EchoMAV/echopilot_ai_carrier/echopilot_ai_carrier_bom.xlsx

EchoPilot AI Carrier - Public Release
Item | Qty | Reference(s) | Value | LibPart | Footprint | Part Num | Notes
1 | 1 | BT1 | MS421R | Device:Battery_Cell | UVDL:SEIKO_ML414H_IV01E | MS421R IV03E
2 | 6 | C1, C2, C3, C4, C20, C21 | 0.1uF | Device:C | Capacitors_SMD:C_0201 | GRM033R61E104KE14J
3 | 2 | C5, C6 | 1000pF | Device:C | Capacitors_SMD:C_0201 | GRM033R71H102KA12D
4 | 6 | C7, C8, C10, C11, C12, C13 | 2.2uF 100V | Device:C | Capacitors_SMD:C_1206 | 12061C225KAT2A
5 | 1 | C9 | 10uF 100V | Device:C | Capacitors_SMD:C_1210 | GRM32EC72A106KE05L
6 | 2 | C14, C15 | 10nF | Device:C | Capacitors_SMD:C_0201 | GRM033R71E103KE14D
7 | 2 | C16, C17 | 4.7nF | Device:C | Capacitors_SMD:C_0201 | GRM033R61E472KA12D
8 | 2 | C18, C19 | 47pF | Device:C | Capacitors_SMD:C_0402 | C0402C470J3RACAUTO
9 | 6 | C22, C23, C24, C25, C26, C27 | 47uF 10V | Device:C | Capacitors_SMD:C_1206 | CL31A476MPHNNNE
10 | 7 | C28, C29, C33, C34, C38, C39, C41 | 0.1uF | Device:C | Capacitor_SMD:C_0201_0603Metric | GRM033R61E104KE14J
11 | 4 | C30, C31, C35, C36 | 47pF | Device:C | Capacitor_SMD:C_0201_0603Metric | 02013A470JAT2A
12 | 3 | C32, C37, C40 | 4.7uF | Device:C | Capacitor_SMD:C_0805_2012Metric | CL21B475KOFNFNE
13 | 3 | C42, C43, C44 | 1.0uF | Device:C | Capacitor_SMD:C_0805_2012Metric | C2012X7R1E105K125AB
14 | 1 | C45 | 0.1uF | Device:C | Capacitor_SMD:C_0402_1005Metric | CL05B104KB5NNNC
15 | 1 | C46 | 1.0uF | Device:C | Capacitor_SMD:C_0201_0603Metric | CL03A105MO3NRNH
16 | 1 | C47 | 5600pF | Device:C | Capacitor_SMD:C_0201_0603Metric | GRM033R61E562KA12D
17 | 1 | C48 | 0.47uF | Device:C | Capacitor_SMD:C_0201_0603Metric | EMK063BBJ474KPLF
18 | 1 | D1 | TVS | osrf_device_fork:TVS | Diodes_SMD:D_SOD-123F | ATV02W101B-HF
19 | 2 | D2, D3 | PDS760-13 | Device:D_Schottky | UVDL:PDS760-13 | PDS760-13
20 | 2 | D4, D5 | LED_G | Device:LED | LEDs:LED_0603 | 150060VS75000
21 | 1 | D6 | D_Zener | Device:D_Zener | Diodes_SMD:D_SOD-523 | MM5Z12VT1G
22 | 1 | D7 | ZLLS410TA | Device:D_Schottky | Diode_SMD:D_SOD-323 | ZLLS410TA
23 | 2 | D8, D9 | D_Schottky | Device:D_Schottky | Diode_SMD:D_SMA | B340LA-13-F
24 | 1 | D10 | D_Schottky | Device:D_Schottky | Diode_SMD:D_0402_1005Metric | CDBQC0130L-HF
25 | 1 | D11 | Part Num | Diode:1.5KExxA | Diode_SMD:D_0402_1005Metric | PESD0402-140
26 | 1 | F1 | 0603L100SLYR | Device:Polyfuse | Fuse:Fuse_0603_1608Metric | 0603L100SLYR
27 | 2 | FB1, FB2 | MPZ1608Y101BTA00 | Device:FerriteBead | Inductor_SMD:L_0603_1608Metric | MPZ1608Y101BTA00
28 | 2 | FL1, FL2 | ECMF02-2AMX6 | archangel:ECMF02 | UVDL:QFN-6L_STM | ECMF02-2AMX6
29 | 2 | J5, J6 | FX23L-80P-0.5SV8 | fx23l-80p-0.5sv8:FX23L-80P-0.5SV8 | UVDL:Hirose-FX23L-80P-0.5SV8-MFG | FX23L-80P-0.5SV8 | optional, increase to 10mm gap between boards to provide additional clearance, use FX23L-80P-0.5SV10
30 | 2 | J7, J29 | USB_C_Receptacle_USB2.0 | Connector:USB_C_Receptacle_USB2.0 | Connector_USB:USB_C_Receptacle_Amphenol_12401610E4-2A | 12401610E4#2A
31 | 1 | J8 | 1-84952-5 | :Conn_01x15_1 | UVDL:TE_1-84952-5 | 1-84952-5
32 | 9 | J9, J15, J17, J19, J21, J22, J23, J24, J25 | Conn_01x04 | Connector_Generic:Conn_01x04 | Connector_JST:JST_GH_SM04B-GHS-TB_1x04-1MP_P1.25mm_Horizontal | SM04B-GHS-TB(LF)(SN)
33 | 1 | J10 | 532617010 | Connector_Generic:Conn_01x10 | Connectors_Molex:Molex_PicoBlade_53261-1071_10x1.25mm_Angled | 532617010
34 | 1 | J11 | Conn_01x02 | Connector_Generic:Conn_01x02 | Connectors_JST:JST_GH_SM02B-GHS-TB_02x1.25mm_Angled | SM02B-GHS-TB(LF)(SN)
35 | 1 | J12 | Conn_01x04 | Connector_Generic:Conn_01x04 | Connectors_JST:JST_GH_SM04B-GHS-TB_04x1.25mm_Angled | SM04B-GHS-TB(LF)(SN)
36 | 2 | J13, J26 | Conn_01x03 | Connector_Generic:Conn_01x03 | Connector_JST:JST_GH_SM03B-GHS-TB_1x03-1MP_P1.25mm_Horizontal | SM03B-GHS-TB(LF)(SN)
37 | 1 | J14 | 1-84952-5 | Connector_Generic:Conn_01x15 | UVDL:TE_1-84952-5 | 1-84952-5
38 | 1 | J16 | Conn_01x03 | Connector_Generic:Conn_01x03 | Connectors_JST:JST_GH_SM03B-GHS-TB_03x1.25mm_Angled | SM03B-GHS-TB(LF)(SN)
39 | 1 | J18 | Conn_01x06 | Connector_Generic:Conn_01x06 | Connector_JST:JST_GH_SM06B-GHS-TB_1x06-1MP_P1.25mm_Horizontal | SM06B-GHS-TB(LF)(SN)
40 | 1 | J20 | Conn_01x10 | Connector_Generic:Conn_01x10 | Connectors_JST:JST_GH_SM10B-GHS-TB_10x1.25mm_Angled | SM10B-GHS-TB(LF)(SN)
41 | 1 | J27 | XT30PW-M | Connector_Generic:Conn_01x02 | UVDL:AMASS_XT30PW-M_1x02_P2.50mm_Horizontal | XT30PW-M
42 | 1 | J28 | Conn_01x14 | Connector_Generic:Conn_01x14 | Connector_JST:JST_GH_SM14B-GHS-TB_1x14-1MP_P1.25mm_Horizontal | SM14B-GHS-TB(LF)(SN)-
43 | 2 | L1, L2 | ASPIAIG-F1040-7R3M-T | Device:L | UVDL:ASPIAIG-F1040-7R3M-T | ASPIAIG-F1040-7R3M-T
44 | 1 | L3 | 47uH | Device:L | UVDL:IND_LQH32CN470K23L | LQH32CN470K23L
45 | 1 | Q1 | Q_NMOS_GSD | Device:Q_NMOS_GSD | TO_SOT_Packages_SMD:SOT-23 | BSS214NH6327XTSA1
46 | 1 | Q2 | SQJ463EP-T1_GE3 | 2023-02-23_20-09-27:SQJ463EP-T1_GE3 | UVDL:TO_63EP-T1_GE3_VIS | SQJ463EP-T1_GE3
47 | 2 | R1, R28 | 10K | Device:R | Resistor_SMD:R_0201_0603Metric | ERJ-1GNF1002C
48 | 1 | R2 | 220 | Device:R | Resistor_SMD:R_0201_0603Metric | ERJ-1GNF2200C
49 | 2 | R3, R4 | 75 | Device:R | Resistor_SMD:R_0201_0603Metric | ERJ-1GNF75R0C
50 | 1 | R5 | 750m | Device:R | Resistors_SMD:R_0402 | ERJ-2BQJR75X
51 | 2 | R6, R7 | 16.9K | Device:R | Resistor_SMD:R_0201_0603Metric | ERJ-1GNF1692C
52 | 2 | R8, R9 | 243K | Device:R | Resistor_SMD:R_0201_0603Metric | ERJ-1GNF2433C
53 | 1 | R14 | 56.0K | Device:R | Resistor_SMD:R_0201_0603Metric | RC0201FR-0756KL
54 | 1 | R10 | 57.6K | Device:R | Resistor_SMD:R_0201_0603Metric | RC0201FR-0757K6L
55 | 4 | R11, R13, R22, R23 | 5.1K | Device:R | Resistor_SMD:R_0201_0603Metric | ERJ-1GNJ512C
56 | 2 | R12, R15 | 10.2K | Device:R | Resistor_SMD:R_0201_0603Metric | ERJ-1GNF1022C
57 | 2 | R16, R17 | 1.0K | Device:R | Resistor_SMD:R_0201_0603Metric | ERJ-1GEF1001C
58 | 1 | R18 | 10K | Device:R | Resistors_SMD:R_0402 | ERJ-PA2J103X
59 | 1 | R19 | 100 | Device:R | Resistor_SMD:R_0201_0603Metric | ERJ-U01F1000C
60 | 4 | R20, R21, R24, R25 | 27 | Device:R | Resistor_SMD:R_0201_0603Metric | ERJ-1GNJ270C
61 | 1 | R26 | 3.3K | Device:R | Resistor_SMD:R_0402_1005Metric | ERJ-PA2F3301X
62 | 1 | R27 | 9.09K | Device:R | Resistor_SMD:R_0201_0603Metric | ERJ-1GNF9091C
63 | 1 | R29 | 100K | Device:R | Resistor_SMD:R_0201_0603Metric | ERJ-1GEF1003C
64 | 1 | R30 | 453K | Device:R | Resistor_SMD:R_0201_0603Metric | ERJ-1GNF4533C
65 | 1 | R31 | 16.5K | Device:R | Resistor_SMD:R_0201_0603Metric | ERJ-1GNF1652C
66 | 1 | SW1 | SW_PUSH | osrf_device_fork:SW_PUSH | UVDL:SW_B3U-1000P | B3U-1000P
67 | 1 | TP1 | TestPoint | Connector:TestPoint | Measurement_Points:Test_Point_Keystone_5015_Micro-Minature | 5015 | Mfg: Keystone
68 | 2 | U1, U2 | HX0068ANLT | Microhard:HX0068ANLT | Nightcrawler:HX0068ANLT_r2 | HX0068ANLT
69 | 2 | U3, U4 | TPS54561QDPRRQ1 | TPS54561DPRR:TPS54561DPRR | UVDL:SON80P400X400X80-11N | TPS54561QDPRRQ1
70 | 2 | U5, U6 | FT231XQ-R | archangel:FT231XQ | UVDL:QFN20_FT231XQ_FTD | FT231XQ-R
71 | 1 | U7 | VN200 | VN200:VN200 | UVDL:7X8CASTLE | DNI | DNI - Optional installation of VectorNAV INS VN-X00
72 | 1 | U8 | AP2112K-3.3 | Regulator_Linear:AP2112K-3.3 | Package_TO_SOT_SMD:SOT-23-5 | AP2112K-3.3TRG1
73 | 1 | U9 | LT3469 | cube_base:LT3469 | Package_TO_SOT_SMD:SOT-23-8 | LT3469ETS8#TRMPBF
