EchoMAV/echopilot_ai_carrier/(threads)

Thread 1 (2024-05-02):

MIPI 3.3V

climr, 2024-05-02:
is limited to 2A by the protection circuit, but the upstream regulator is only rated for 1A.  So a short circuit could damage the regulator.
