EchoMAV/echopilot_ai_carrier/echopilot_ai_carrier_schematic.pdf

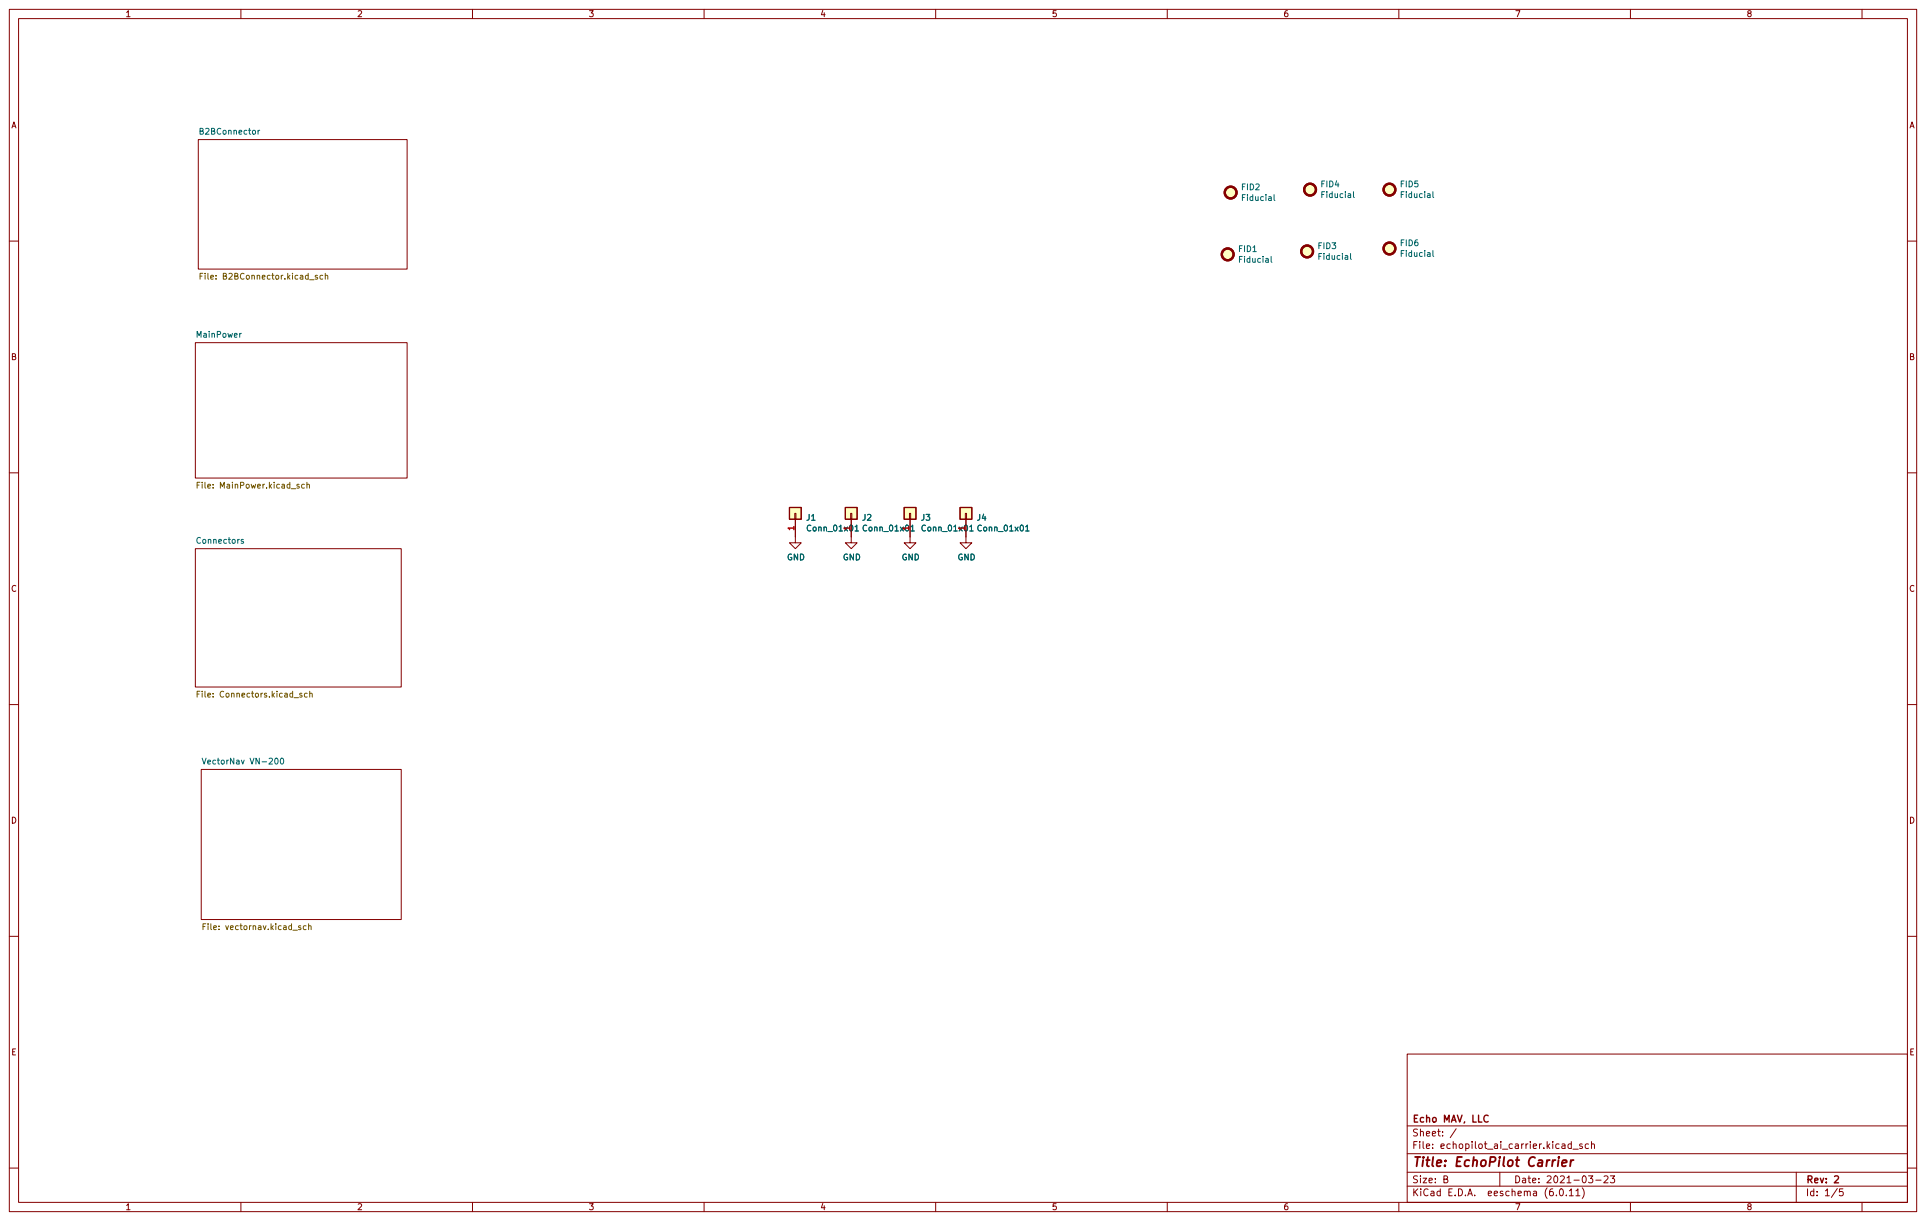
[picture p1: page 1]

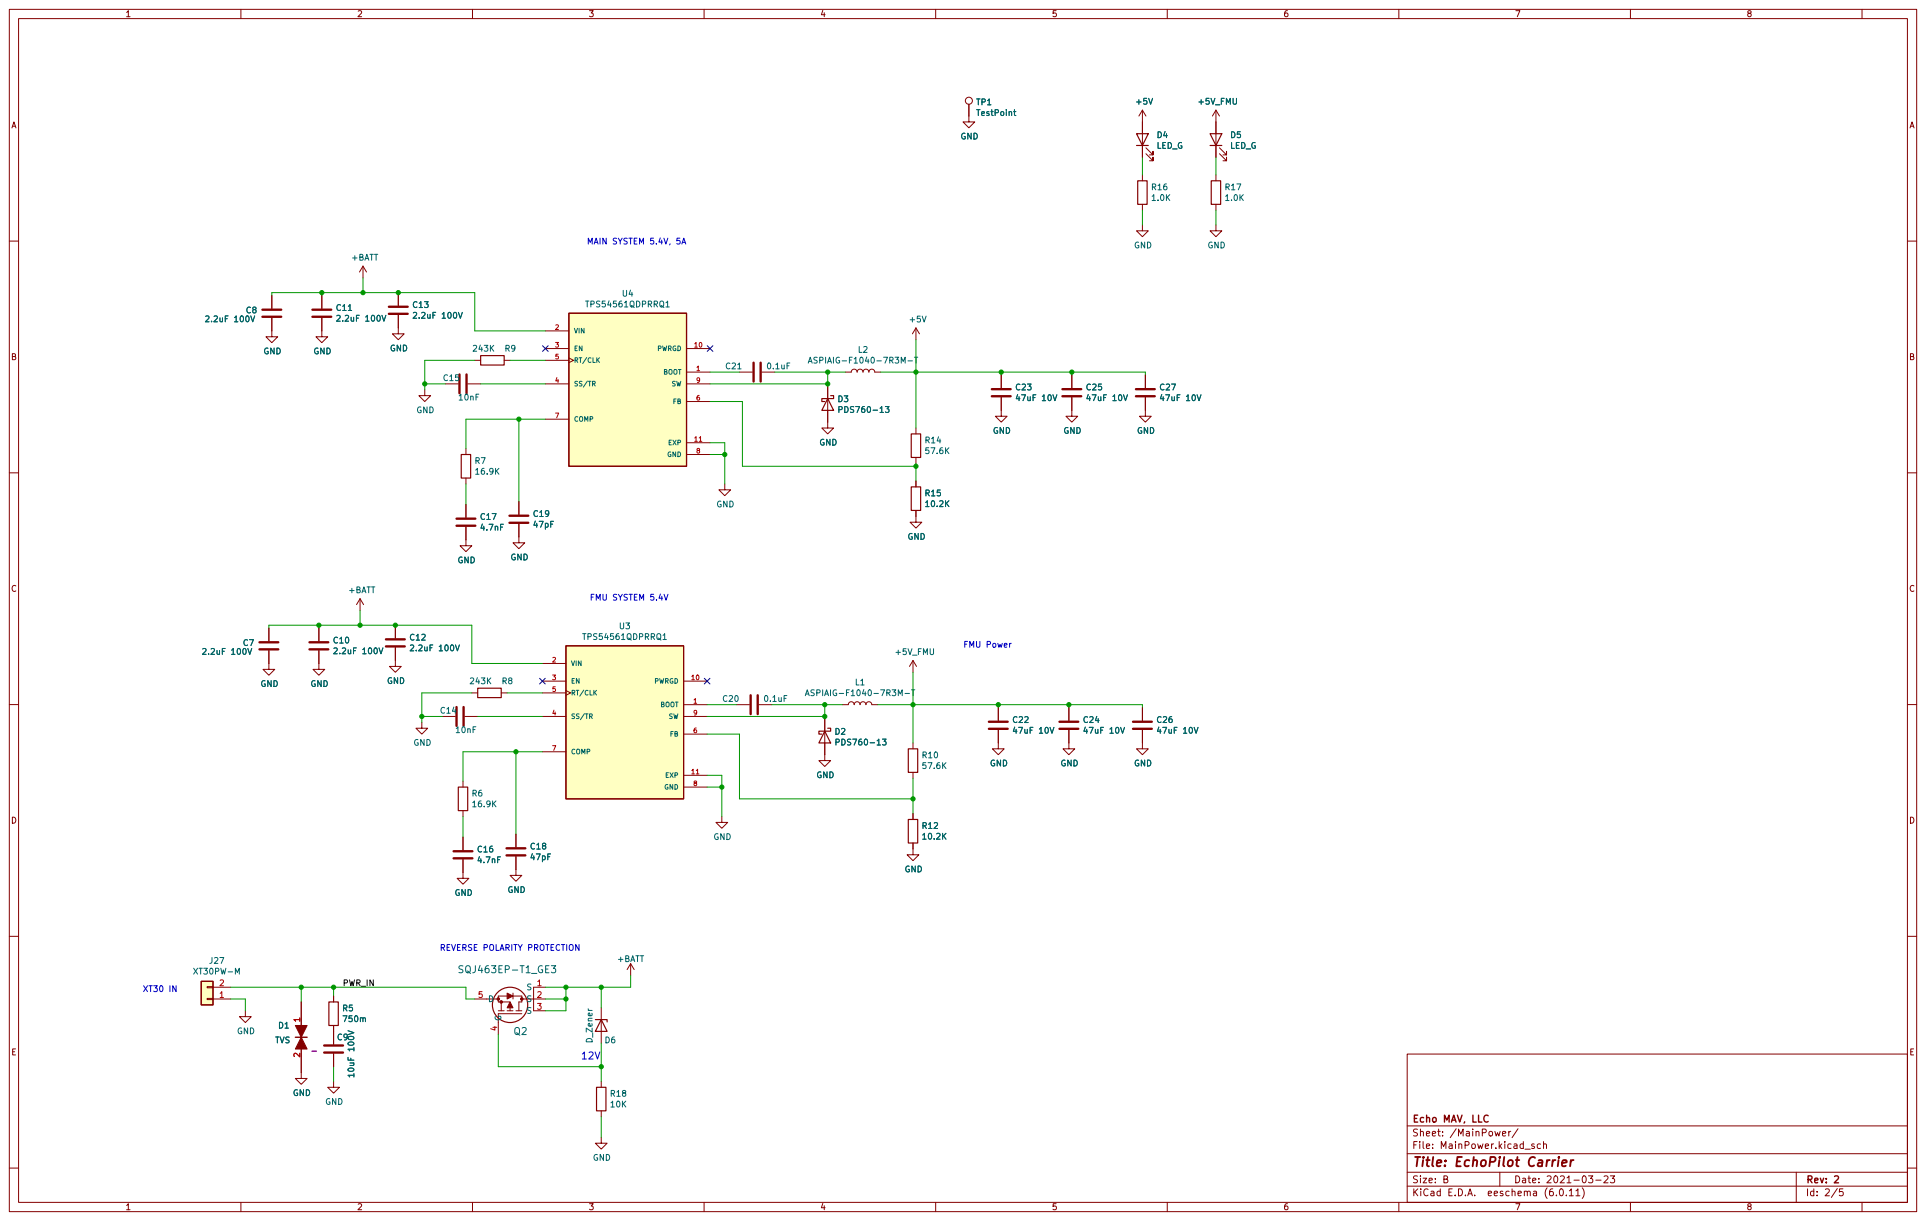
[picture p2: page 2]

FMU Power FMU SYSTEM 5.4V 12V

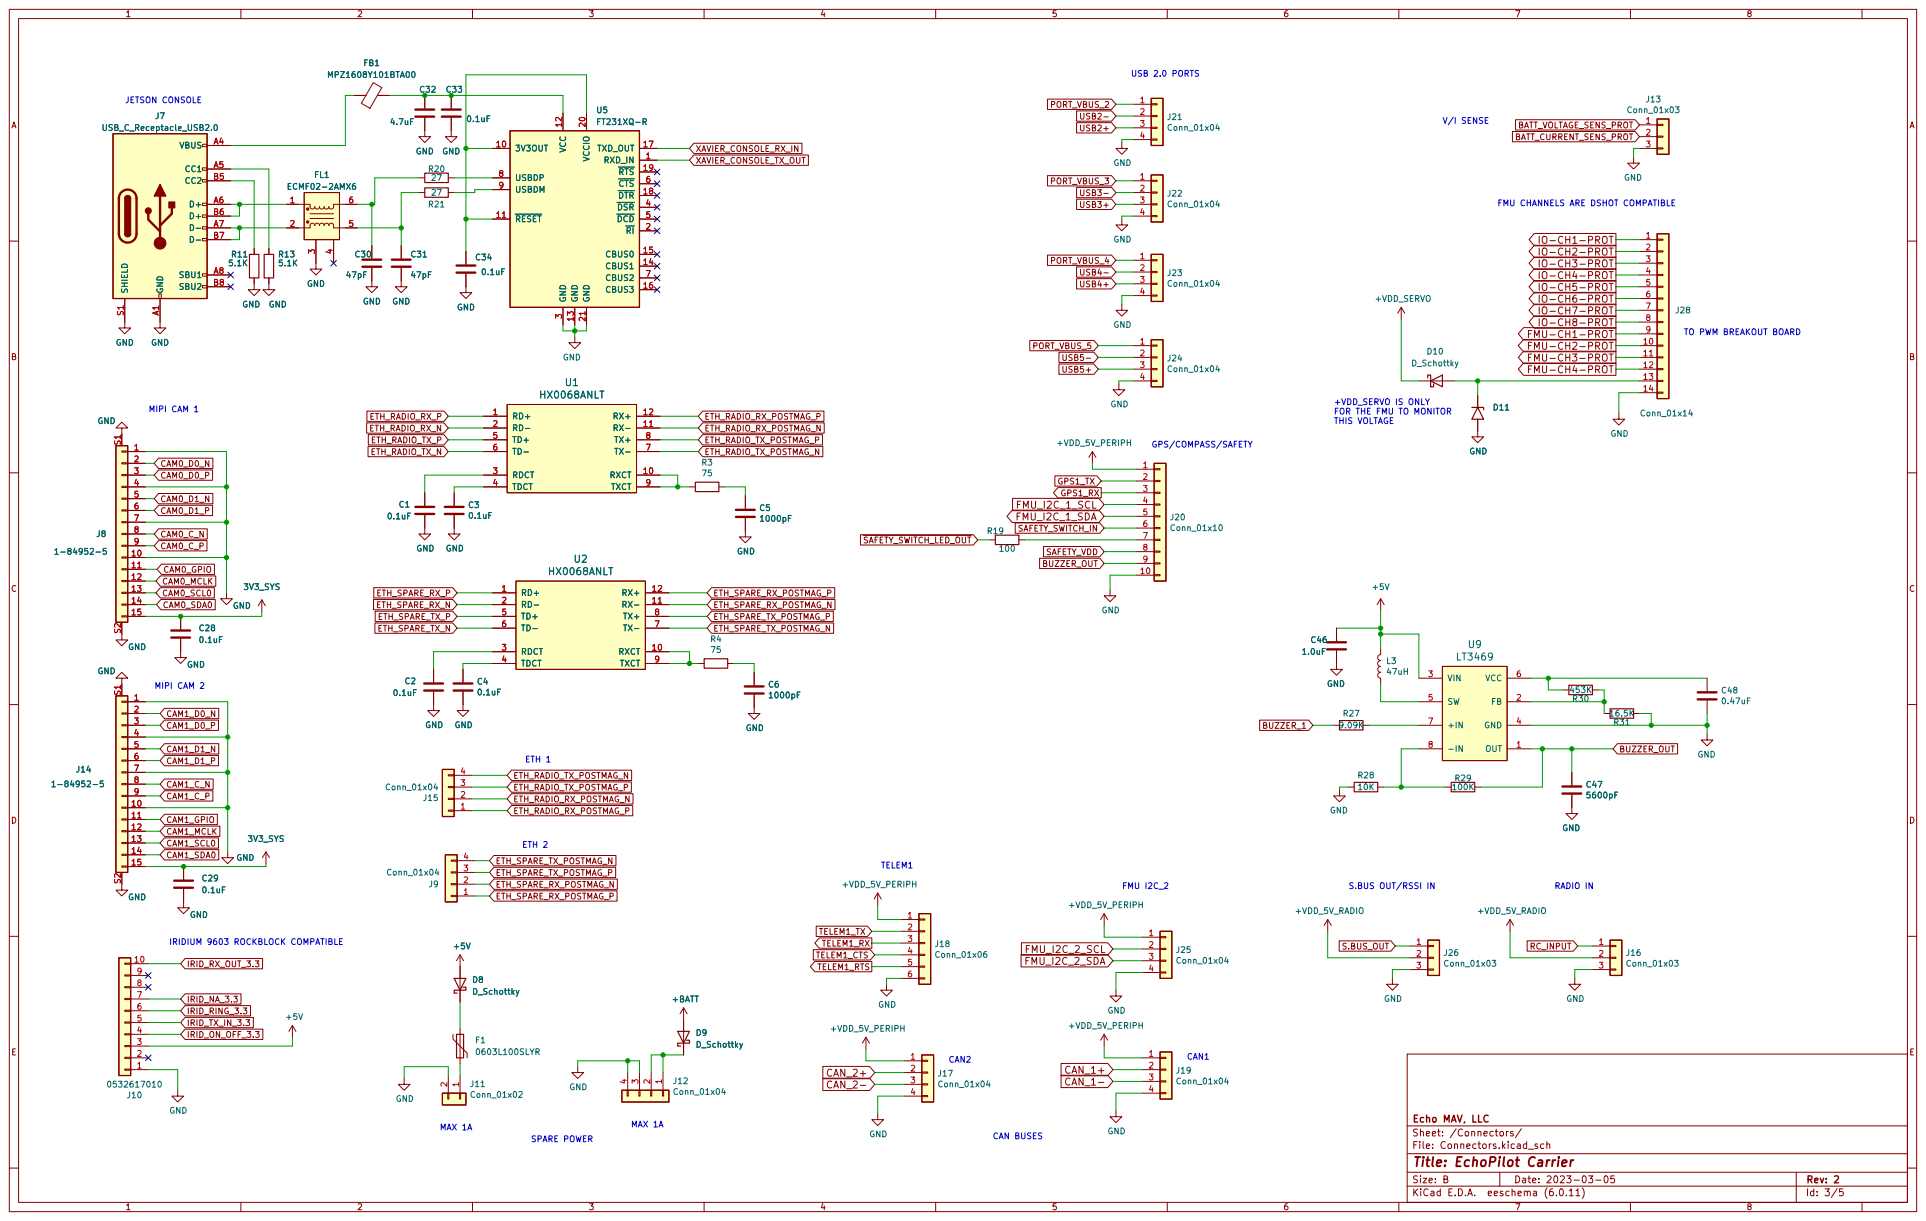
[picture p3: page 3]

3 ~{DSR}4 ~{DCD}5 ~{CTS}6 CBUS2 7 USBDP 8 USBDM 9 C33

3 ~{DSR}4 ~{DCD}5 ~{CTS}6 CBUS2 7 USBDP 8 USBDM 9 U5 FT231XQ-R

FMU CHANNELS ARE DSHOT COMPATIBLE

TO PWM BREAKOUT BOARD GPS/COMPASS/SAFETY MIPI CAM 1

+VDD_SERVO IS ONLY
FOR THE FMU TO MONITOR
THIS VOLTAGE

S.BUS OUT/RSSI IN

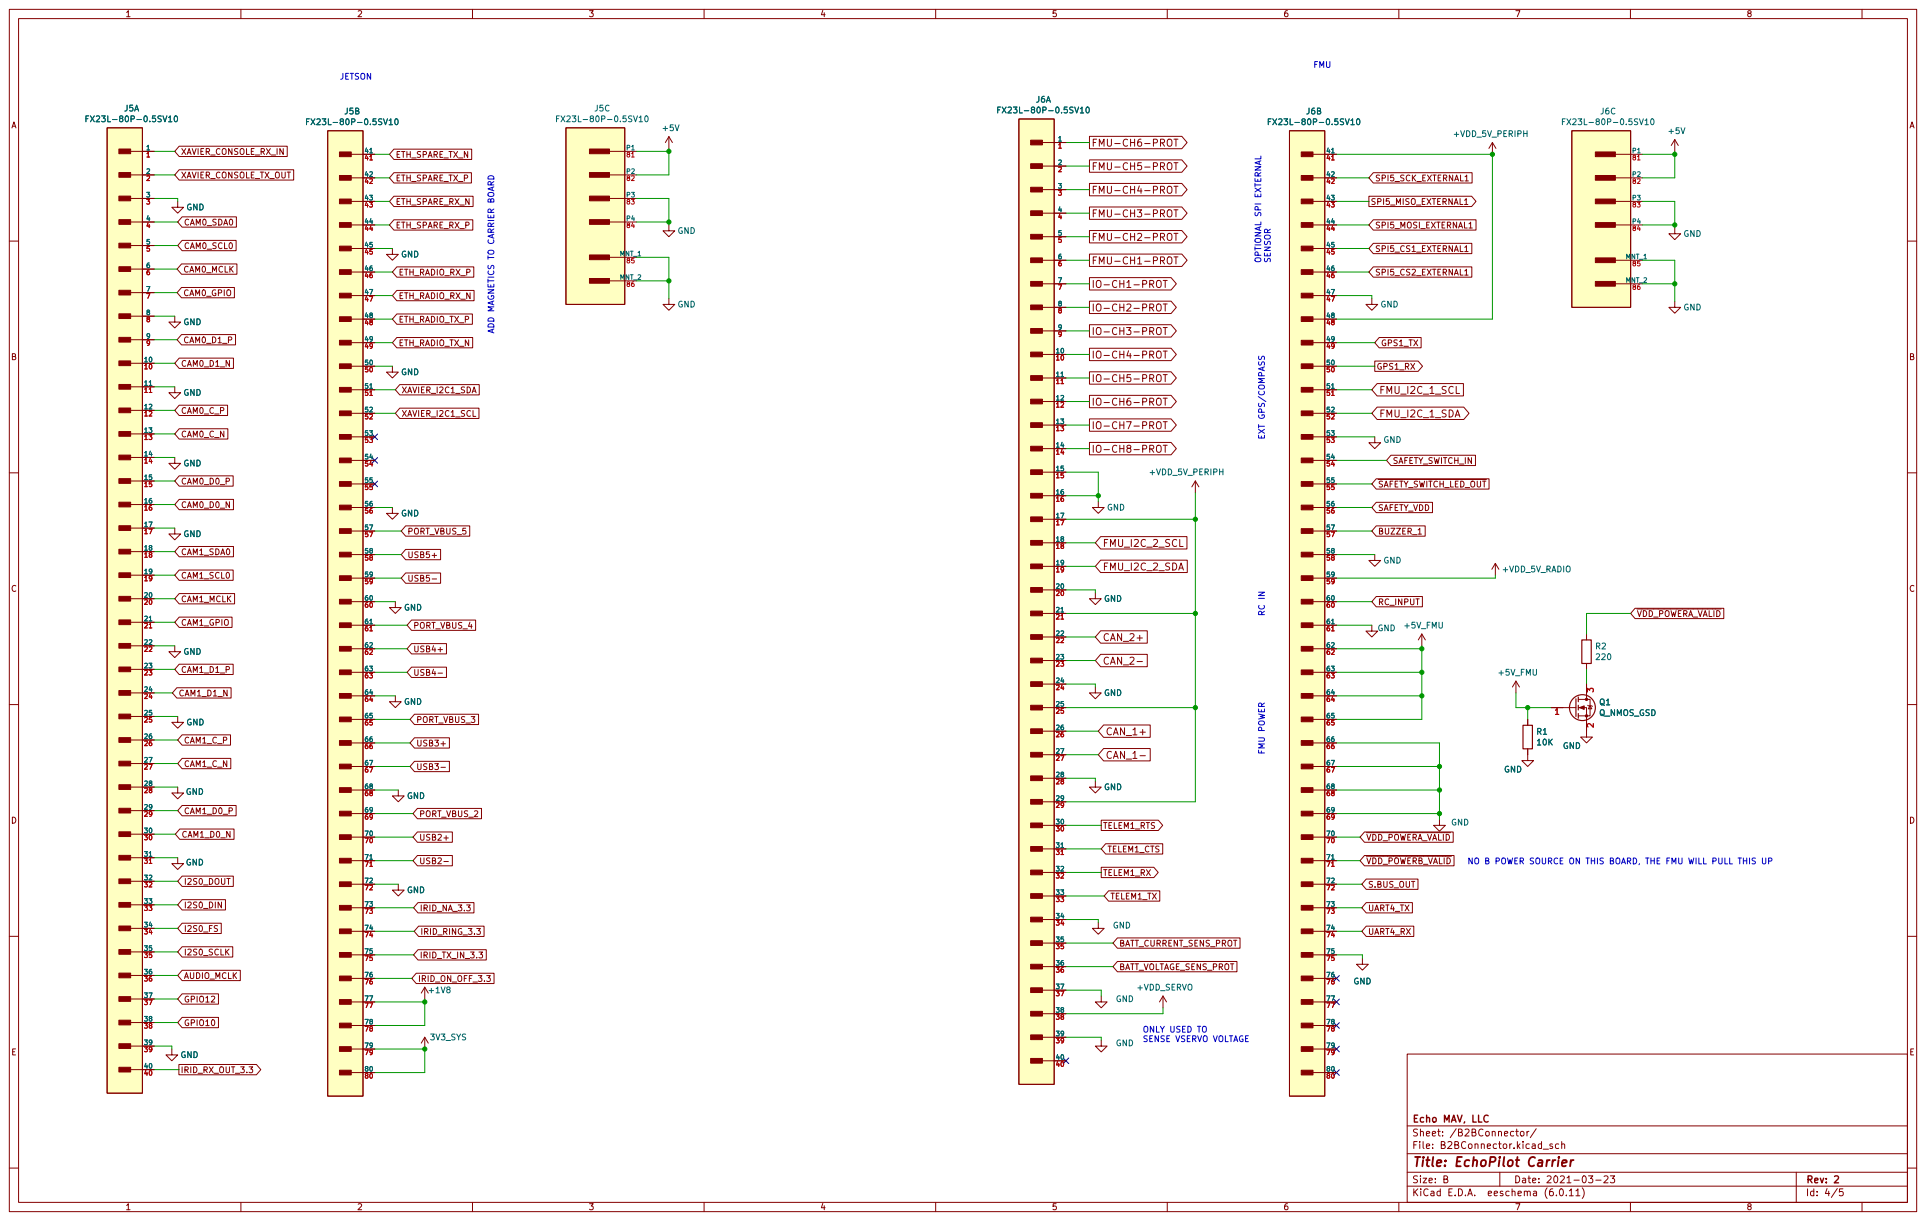
[picture p4: page 4]

SENSE VSERVO VOLTAGE ADD MAGNETICS TO CARRIER BOARD

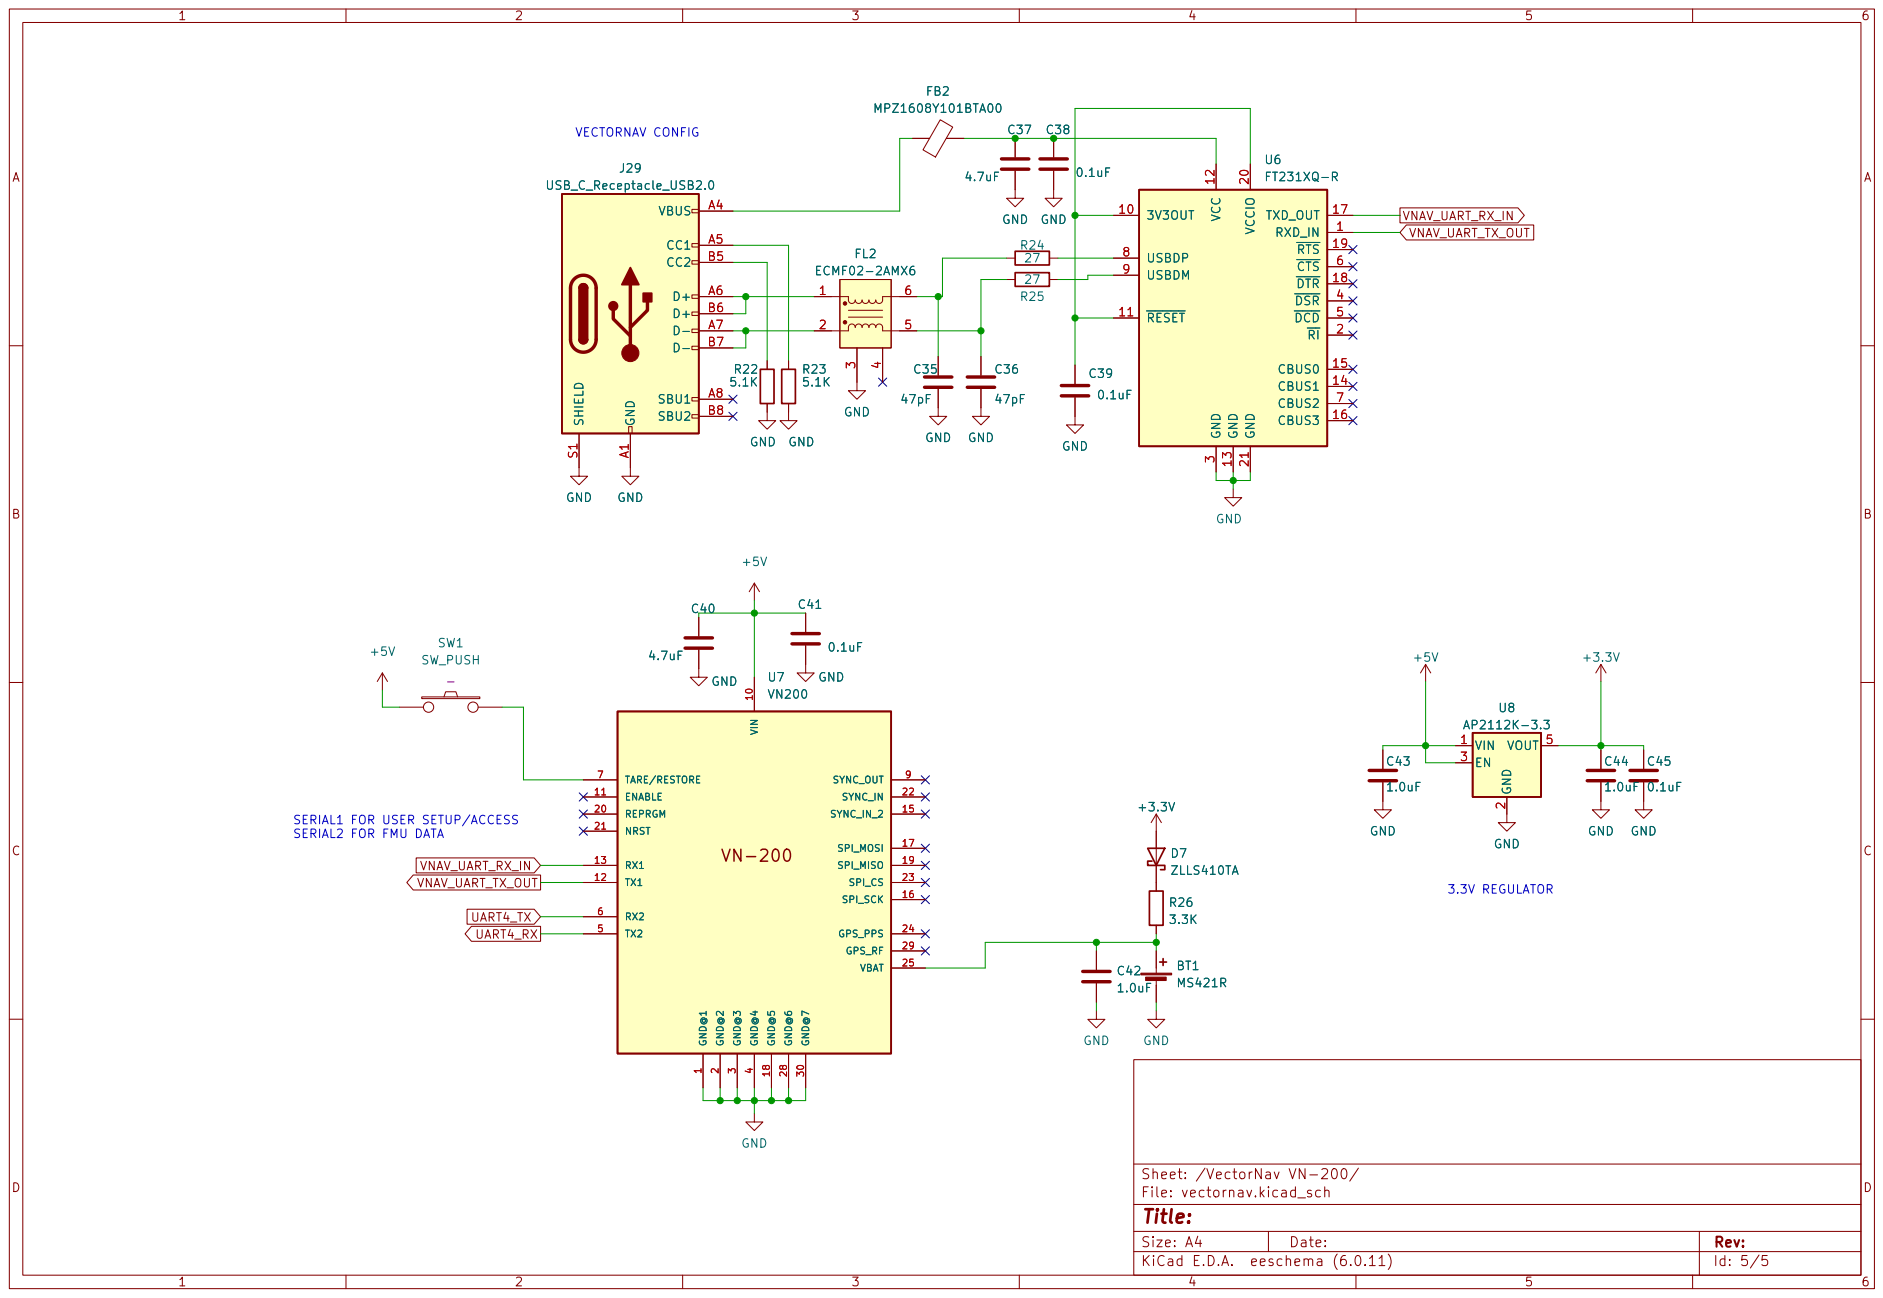
[picture p5: page 5]

4.7uF GND GND VN-200 GND@1

3 ~{DSR}4 ~{DCD}5 ~{CTS}6 CBUS2 7 USBDP 8 USBDM 9 FB2 MPZ1608Y101BTA00 C37

3 ~{DSR}4 ~{DCD}5 ~{CTS}6 CBUS2 7 USBDP 8 USBDM 9 U6 FT231XQ-R

SERIAL1 FOR USER SETUP/ACCESS
