EchoMAV/echopilot_ai_carrier/echopilot_ai_carrier.kicad_pcb

## KiCad design echopilot_ai_carrier.kicad_pcb (2023-05-04)

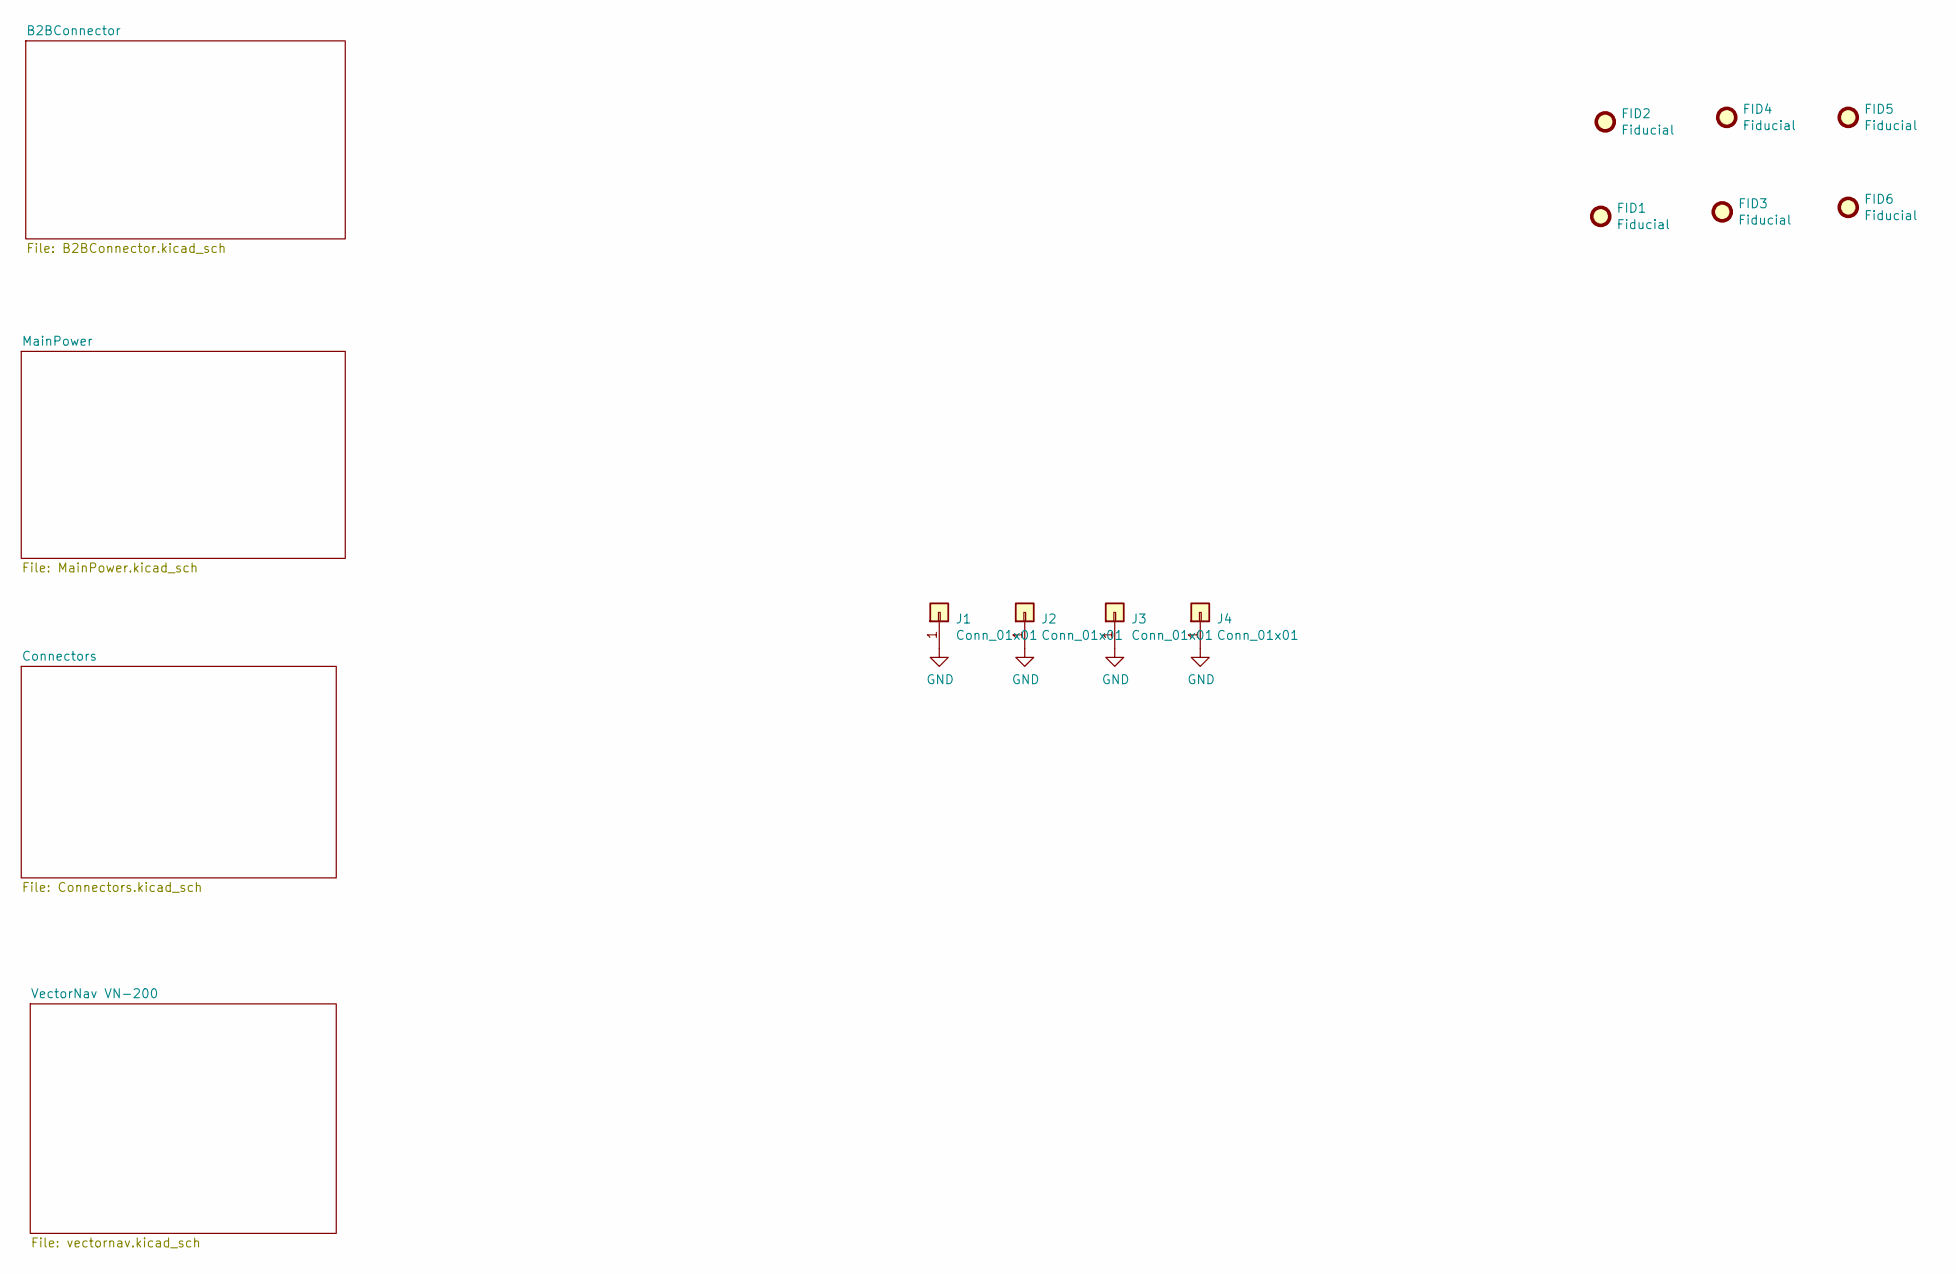
[picture p6: schematic echopilot_ai_carrier.kicad_sch, EchoPilot Carrier]

Parts:
FID1, FID2, FID3, FID4, FID5, FID6: Fiducial; Fiducial_0.5mm_Dia_1mm_Outer; Part Num DNI
J1, J2, J3, J4: Conn_01x01; MountingHole_2.7mm_M2.5_Pad_Via; Part Num DNI

Connections:
GND: J1.1, J2.1, J3.1, J4.1; also elsewhere on the board

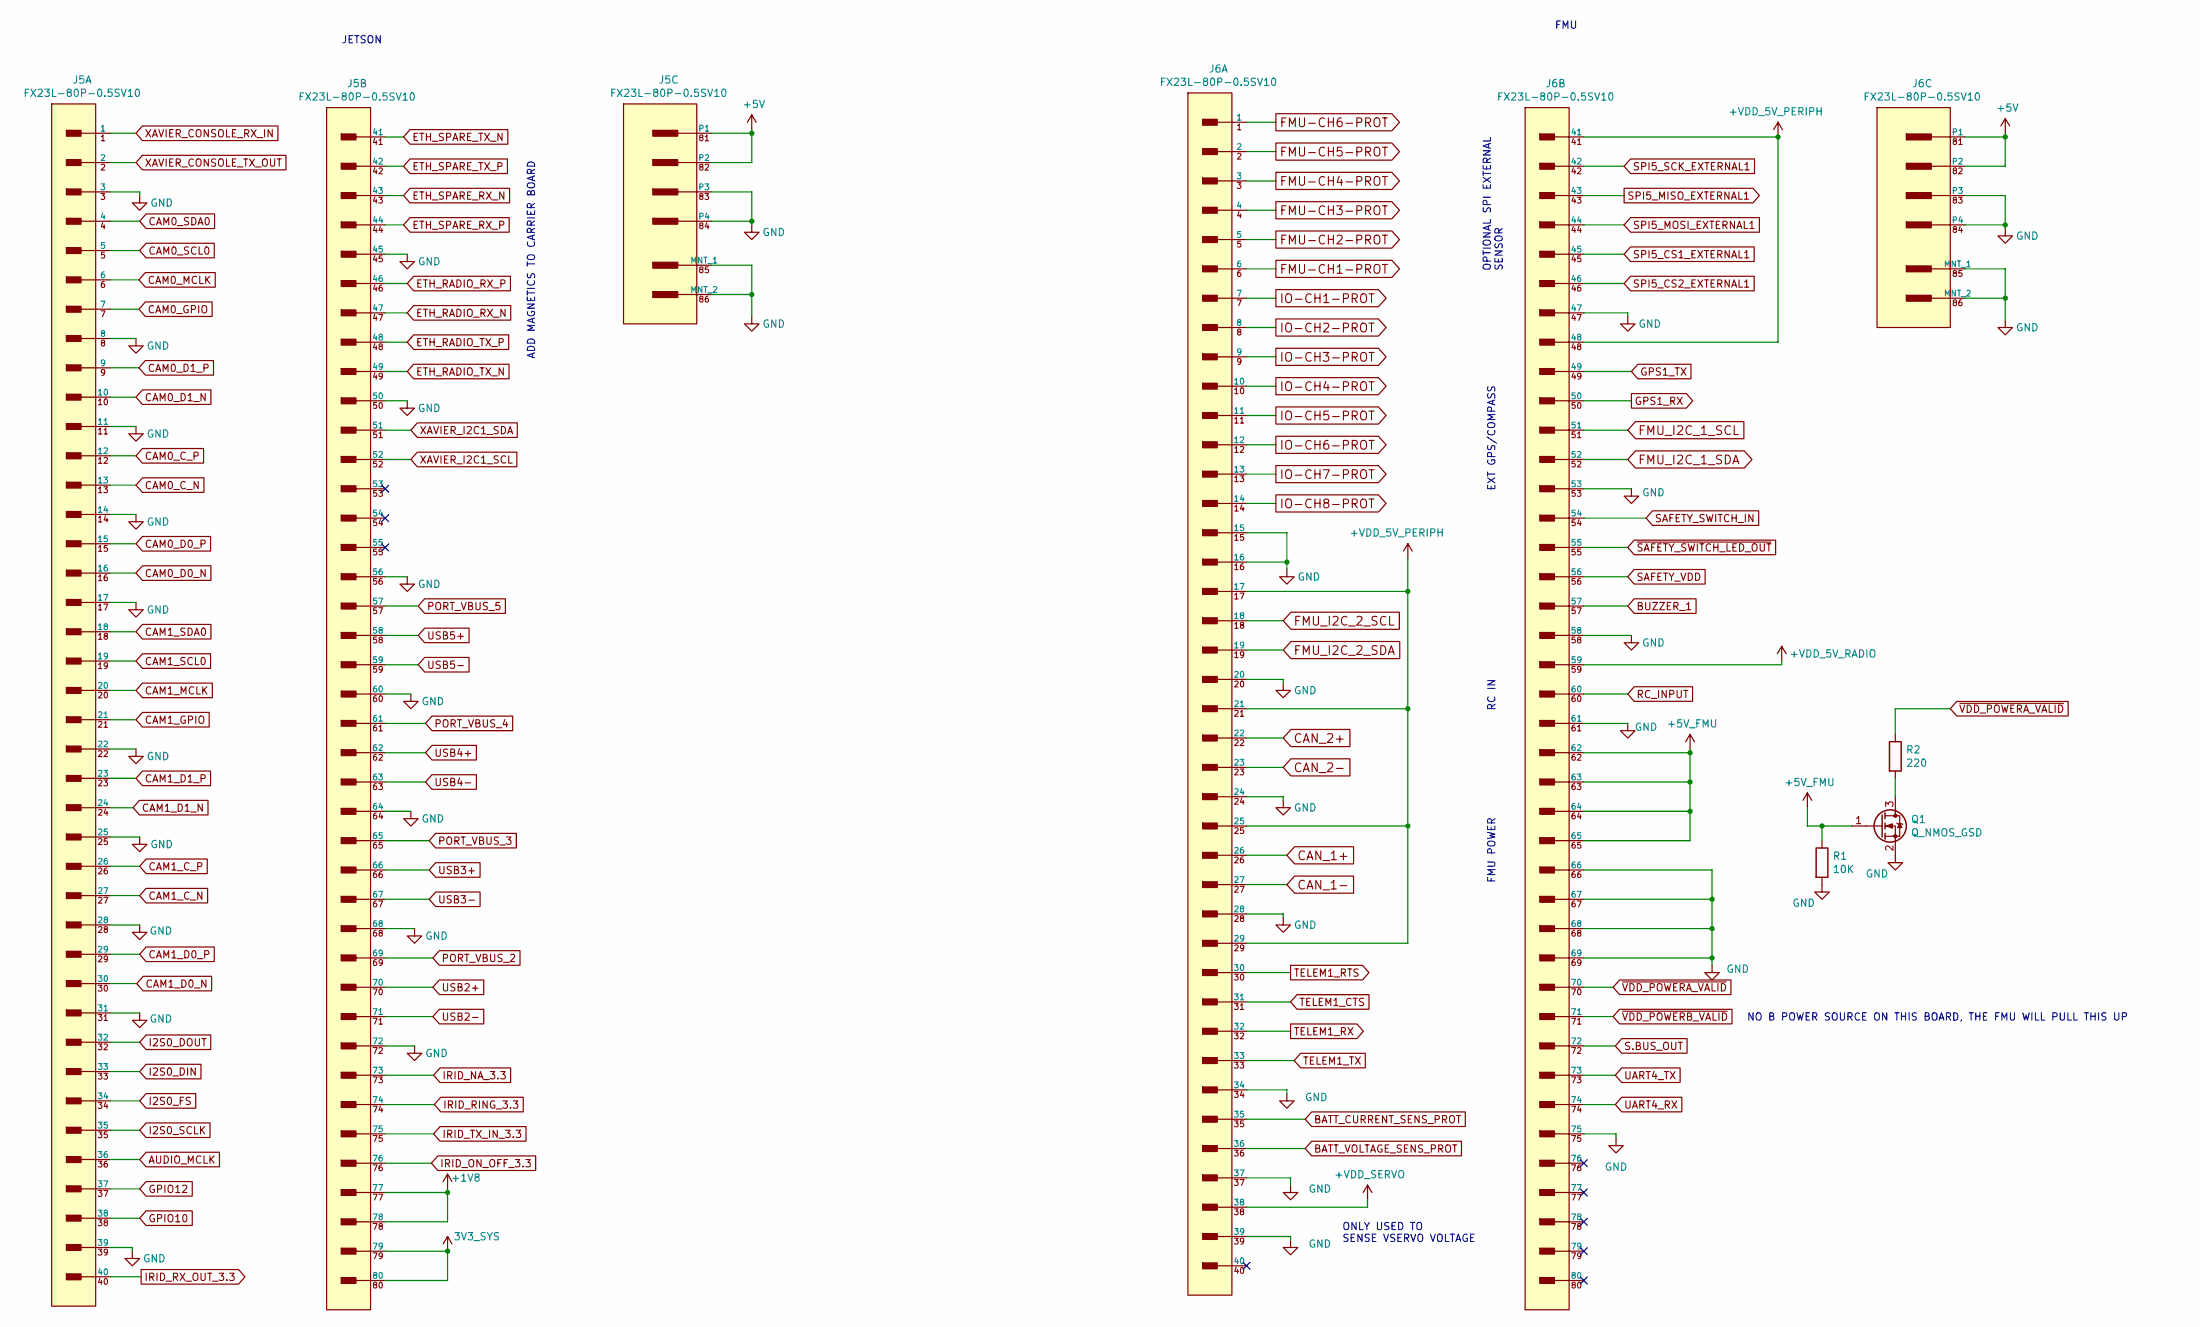
[picture p7: schematic B2BConnector.kicad_sch, EchoPilot Carrier]

Parts:
J5: FX23L-80P-0.5SV10; Hirose-FX23L-80P-0.5SV8-MFG; current rating 0.5/3A; voltage rating 50/200V; mouser part number 798-FX23L-80P-0.5SV8; digikey description CONN HDR
J6: FX23L-80P-0.5SV10; Hirose-FX23L-80P-0.5SV8-MFG; current rating 0.5/3A; voltage rating 50/200V; mouser part number FX23L-80P-0.5SV10; digikey description CONN HDR
Q1: Q_NMOS_GSD; SOT-23; Part Num BSS214NH6327XTSA1
R1: 10K; R_0201_0603Metric; Part Num ERJ-1GNF1002C
R2: 220; R_0201_0603Metric; Part Num ERJ-1GNF2200C

Connections:
3V3_SYS: J5.79, J5.80; also elsewhere on the board
+1V8: J5.77, J5.78
+5V_FMU: J6.62, J6.63, J6.64, J6.65, Q1.1 (G), R1.1; also elsewhere on the board
+VDD_5V_PERIPH: J6.17, J6.21, J6.25, J6.29, J6.41, J6.48; also elsewhere on the board
+VDD_5V_RADIO: J6.59; also elsewhere on the board
+VDD_SERVO: J6.38; also elsewhere on the board
AUDIO_MCLK: J5.36
BATT_CURRENT_SENS_PROT: J6.35; also elsewhere on the board
BATT_VOLTAGE_SENS_PROT: J6.36; also elsewhere on the board
BUZZER_1: J6.57; also elsewhere on the board
CAM0_C_N: J5.13; also elsewhere on the board
CAM0_C_P: J5.12; also elsewhere on the board
CAM0_D0_N: J5.16; also elsewhere on the board
CAM0_D0_P: J5.15; also elsewhere on the board
CAM0_D1_N: J5.10; also elsewhere on the board
CAM0_D1_P: J5.9; also elsewhere on the board
CAM0_GPIO: J5.7; also elsewhere on the board
CAM0_MCLK: J5.6; also elsewhere on the board
CAM0_SCL0: J5.5; also elsewhere on the board
CAM0_SDA0: J5.4; also elsewhere on the board
CAM1_C_N: J5.27; also elsewhere on the board
CAM1_C_P: J5.26; also elsewhere on the board
CAM1_D0_N: J5.30; also elsewhere on the board
CAM1_D0_P: J5.29; also elsewhere on the board
CAM1_D1_N: J5.24; also elsewhere on the board
CAM1_D1_P: J5.23; also elsewhere on the board
CAM1_GPIO: J5.21; also elsewhere on the board
CAM1_MCLK: J5.20; also elsewhere on the board
CAM1_SCL0: J5.19; also elsewhere on the board
CAM1_SDA0: J5.18; also elsewhere on the board
CAN_1+: J6.26; also elsewhere on the board
CAN_1-: J6.27; also elsewhere on the board
CAN_2+: J6.22; also elsewhere on the board
CAN_2-: J6.23; also elsewhere on the board
ETH_RADIO_RX_N: J5.47; also elsewhere on the board
ETH_RADIO_RX_P: J5.46; also elsewhere on the board
ETH_RADIO_TX_N: J5.49; also elsewhere on the board
ETH_RADIO_TX_P: J5.48; also elsewhere on the board
ETH_SPARE_RX_N: J5.43; also elsewhere on the board
ETH_SPARE_RX_P: J5.44; also elsewhere on the board
ETH_SPARE_TX_N: J5.41; also elsewhere on the board
ETH_SPARE_TX_P: J5.42; also elsewhere on the board
FMU-CH1-PROT: J6.6; also elsewhere on the board
FMU-CH2-PROT: J6.5; also elsewhere on the board
FMU-CH3-PROT: J6.4; also elsewhere on the board
FMU-CH4-PROT: J6.3; also elsewhere on the board
FMU-CH5-PROT: J6.2
FMU-CH6-PROT: J6.1
FMU_I2C_1_SCL: J6.51; also elsewhere on the board
FMU_I2C_1_SDA: J6.52; also elsewhere on the board
FMU_I2C_2_SCL: J6.18; also elsewhere on the board
FMU_I2C_2_SDA: J6.19; also elsewhere on the board
GND: J5.3, J5.8, J5.11, J5.14, J5.17, J5.22, J5.25, J5.28, J5.31, J5.39, J5.45, J5.50, J5.56, J5.60, J5.64, J5.68, J5.72, J5.83 (P3), J5.84 (P4), J5.85 (MNT_1), J5.86 (MNT_2), J6.15, J6.16, J6.20, J6.24, J6.28, J6.34, J6.37, J6.39, J6.47, J6.53, J6.58, J6.61, J6.66, J6.67, J6.68, J6.69, J6.75, J6.83 (P3), J6.84 (P4), J6.85 (MNT_1), J6.86 (MNT_2), Q1.2 (S), R1.2; also elsewhere on the board
GPIO10: J5.38
GPIO12: J5.37
GPS1_RX: J6.50; also elsewhere on the board
GPS1_TX: J6.49; also elsewhere on the board
I2S0_DIN: J5.33
I2S0_DOUT: J5.32
I2S0_FS: J5.34
I2S0_SCLK: J5.35
IO-CH1-PROT: J6.7; also elsewhere on the board
IO-CH2-PROT: J6.8; also elsewhere on the board
IO-CH3-PROT: J6.9; also elsewhere on the board
IO-CH4-PROT: J6.10; also elsewhere on the board
IO-CH5-PROT: J6.11; also elsewhere on the board
IO-CH6-PROT: J6.12; also elsewhere on the board
IO-CH7-PROT: J6.13; also elsewhere on the board
IO-CH8-PROT: J6.14; also elsewhere on the board
IRID_NA_3.3: J5.73; also elsewhere on the board
IRID_ON_OFF_3.3: J5.76; also elsewhere on the board
IRID_RING_3.3: J5.74; also elsewhere on the board
IRID_RX_OUT_3.3: J5.40; also elsewhere on the board
IRID_TX_IN_3.3: J5.75; also elsewhere on the board
unnamed: Q1.3 (D), R2.2
PORT_VBUS_2: J5.69; also elsewhere on the board
PORT_VBUS_3: J5.65; also elsewhere on the board
PORT_VBUS_4: J5.61; also elsewhere on the board
PORT_VBUS_5: J5.57; also elsewhere on the board
RC_INPUT: J6.60; also elsewhere on the board
S.BUS_OUT: J6.72; also elsewhere on the board
SAFETY_SWITCH_IN: J6.54; also elsewhere on the board
SAFETY_VDD: J6.56; also elsewhere on the board
SPI5_CS1_EXTERNAL1: J6.45
SPI5_CS2_EXTERNAL1: J6.46
SPI5_MISO_EXTERNAL1: J6.43
SPI5_MOSI_EXTERNAL1: J6.44
SPI5_SCK_EXTERNAL1: J6.42
TELEM1_CTS: J6.31; also elsewhere on the board
TELEM1_RTS: J6.30; also elsewhere on the board
TELEM1_RX: J6.32; also elsewhere on the board
TELEM1_TX: J6.33; also elsewhere on the board
UART4_RX: J6.74; also elsewhere on the board
UART4_TX: J6.73; also elsewhere on the board
USB2+: J5.70; also elsewhere on the board
USB2-: J5.71; also elsewhere on the board
USB3+: J5.66; also elsewhere on the board
USB3-: J5.67; also elsewhere on the board
USB4+: J5.62; also elsewhere on the board
USB4-: J5.63; also elsewhere on the board
USB5+: J5.58; also elsewhere on the board
USB5-: J5.59; also elsewhere on the board
XAVIER_CONSOLE_RX_IN: J5.1; also elsewhere on the board
XAVIER_CONSOLE_TX_OUT: J5.2; also elsewhere on the board
XAVIER_I2C1_SCL: J5.52
XAVIER_I2C1_SDA: J5.51
~SAFETY_SWITCH_LED_OUT: J6.55; also elsewhere on the board
~VDD_POWERA_VALID: J6.70, R2.1
~VDD_POWERB_VALID: J6.71

Notes on the sheet:
ADD MAGNETICS TO CARRIER BOARD
OPTIONAL SPI EXTERNAL SENSOR
RC IN
NO B POWER SOURCE ON THIS BOARD, THE FMU WILL PULL THIS UP
FMU
FMU POWER
ONLY USED TO SENSE VSERVO VOLTAGE
JETSON
EXT GPS/COMPASS

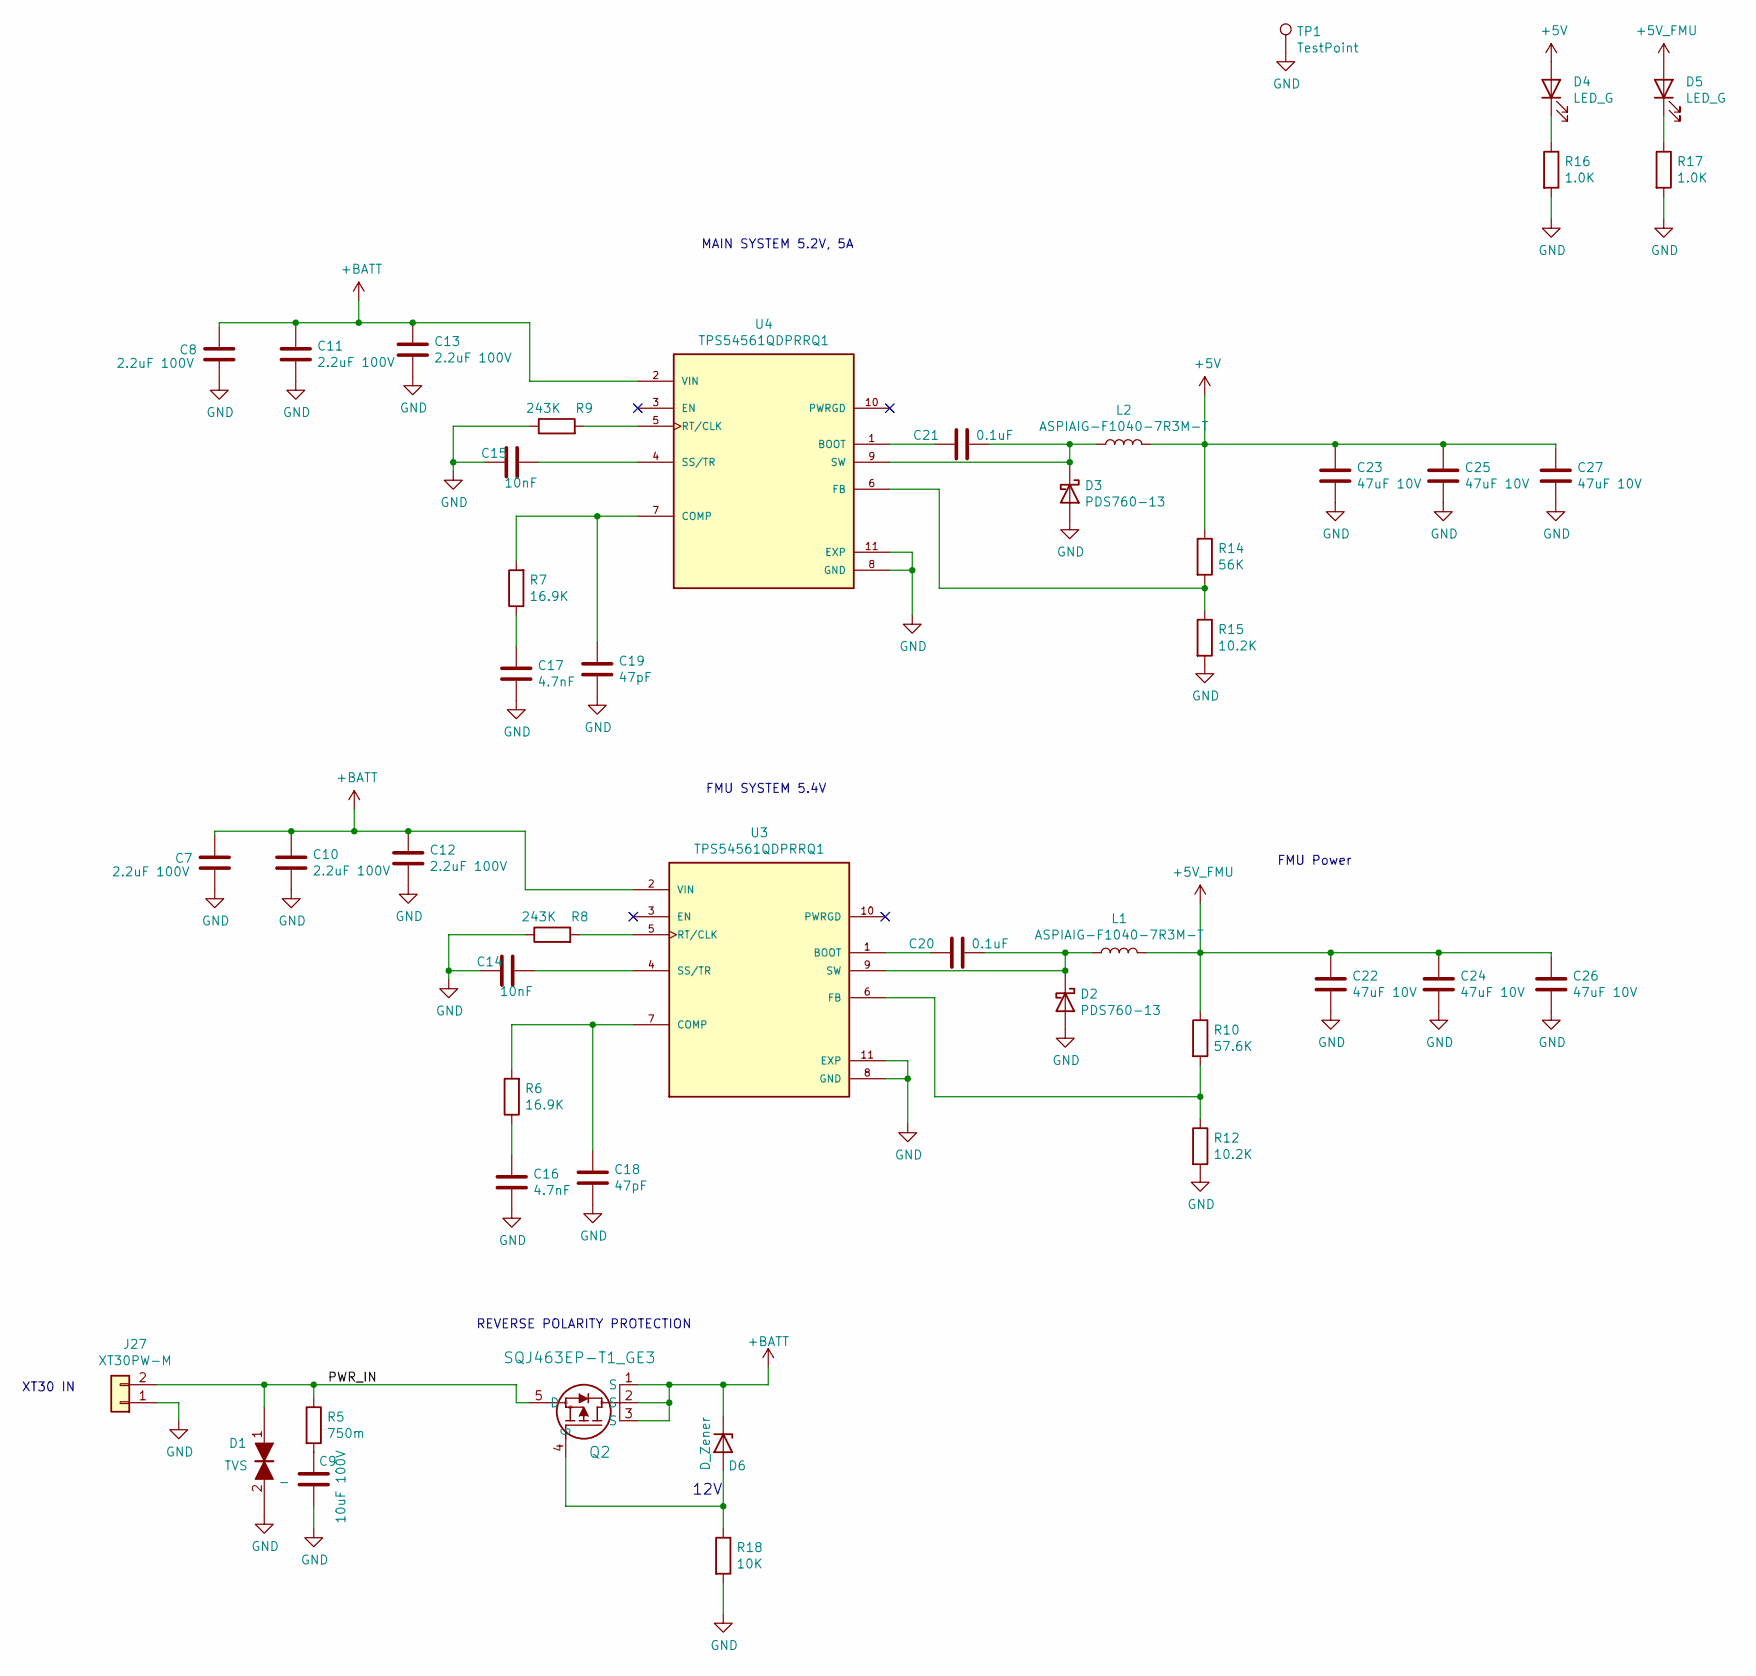
[picture p8: schematic MainPower.kicad_sch, EchoPilot Carrier]

Parts:
C7, C8, C10, C11, C12, C13: 2.2uF 100V; C_1206; Part Num 12061C225KAT2A
C9: 10uF 100V; C_1210; Part Num GRM32EC72A106KE05L
C14, C15: 10nF; C_0201; Part Num GRM033R71E103KE14D
C16, C17: 4.7nF; C_0201; Part Num GRM033R61E472KA12D
C18, C19: 47pF; C_0402; Part Num C0402C470J3RACAUTO
C20, C21: 0.1uF; C_0201; Part Num GRM033R61E104KE14J
C22, C23, C24, C25, C26, C27: 47uF 10V; C_1206; Part Num CL31A476MPHNNNE
D1: TVS; D_SOD-123F; Voltage _; Tolerance _; Part Num ATV02W101B-HF
D2, D3: PDS760-13; Part Num PDS760-13
D4, D5: LED_G; LED_0603; Part Num 150060VS75000
D6: D_Zener; D_SOD-523; Part Num MM5Z12VT1G
J27: XT30PW-M; AMASS_XT30PW-M_1x02_P2.50mm_Horizontal; Part Num XT30PW-M
L1, L2: ASPIAIG-F1040-7R3M-T; Part Num ASPIAIG-F1040-7R3M-T
Q2: SQJ463EP-T1_GE3; TO_63EP-T1_GE3_VIS; Part Num SQJ463EP-T1_GE3
R5: 750m; R_0402; Part Num ERJ-2BQJR75X
R6, R7: 16.9K; R_0201_0603Metric; Part Num ERJ-1GNF1692C
R8, R9: 243K; R_0201_0603Metric; Part Num ERJ-1GNF2433C
R10: 57.6K; R_0201_0603Metric; Part Num RC0201FR-0757K6L
R12, R15: 10.2K; R_0201_0603Metric; Part Num ERJ-1GNF1022C
R14: 56K; R_0201_0603Metric; Part Num RC0201FR-0756KL
R16, R17: 1.0K; R_0201_0603Metric; Part Num ERJ-1GEF1001C
R18: 10K; R_0402; Part Num ERJ-PA2J103X
TP1: TestPoint; Test_Point_Keystone_5015_Micro-Minature; Part Num 5015
U3, U4: TPS54561QDPRRQ1; SON80P400X400X80-11N; PARTREV F

Connections:
+5V_FMU: C22.1, C24.1, C26.1, D5.2 (A), L1.2, R10.1; also elsewhere on the board
+BATT: C7.1, C8.1, C10.1, C11.1, C12.1, C13.1, D6.1 (K), Q2.1 (S), Q2.2 (S), Q2.3 (S), U3.2 (VIN), U4.2 (VIN); also elsewhere on the board
/MainPower/PWR_IN: D1.1, J27.2, Q2.5 (D), R5.1
GND: C7.2, C8.2, C9.2, C10.2, C11.2, C12.2, C13.2, C14.2, C15.2, C16.2, C17.2, C18.2, C19.2, C22.2, C23.2, C24.2, C25.2, C26.2, C27.2, D1.2, D2.2 (A), D3.2 (A), J27.1, R8.1, R9.1, R12.2, R15.2, R16.2, R17.2, R18.2, TP1.1, U3.8 (GND), U3.11 (EXP), U4.8 (GND), U4.11 (EXP); also elsewhere on the board
unnamed: C9.1, R5.2
unnamed: C14.1, U3.4 (SS/TR)
unnamed: C15.1, U4.4 (SS/TR)
unnamed: C16.1, R6.1
unnamed: C17.1, R7.1
unnamed: C18.1, R6.2, U3.7 (COMP)
unnamed: C19.1, R7.2, U4.7 (COMP)
unnamed: C20.1, D2.1 (K), L1.1, U3.9 (SW)
unnamed: C20.2, U3.1 (BOOT)
unnamed: C21.1, D3.1 (K), L2.1, U4.9 (SW)
unnamed: C21.2, U4.1 (BOOT)
unnamed: D4.1 (K), R16.1
unnamed: D5.1 (K), R17.1
unnamed: D6.2 (A), Q2.4 (G), R18.1
unnamed: R8.2, U3.5 (RT/CLK)
unnamed: R9.2, U4.5 (RT/CLK)
unnamed: R10.2, R12.1, U3.6 (FB)
unnamed: R14.2, R15.1, U4.6 (FB)

Notes on the sheet:
FMU SYSTEM 5.4V
REVERSE POLARITY PROTECTION
MAIN SYSTEM 5.2V, 5A
12V
XT30 IN
FMU Power

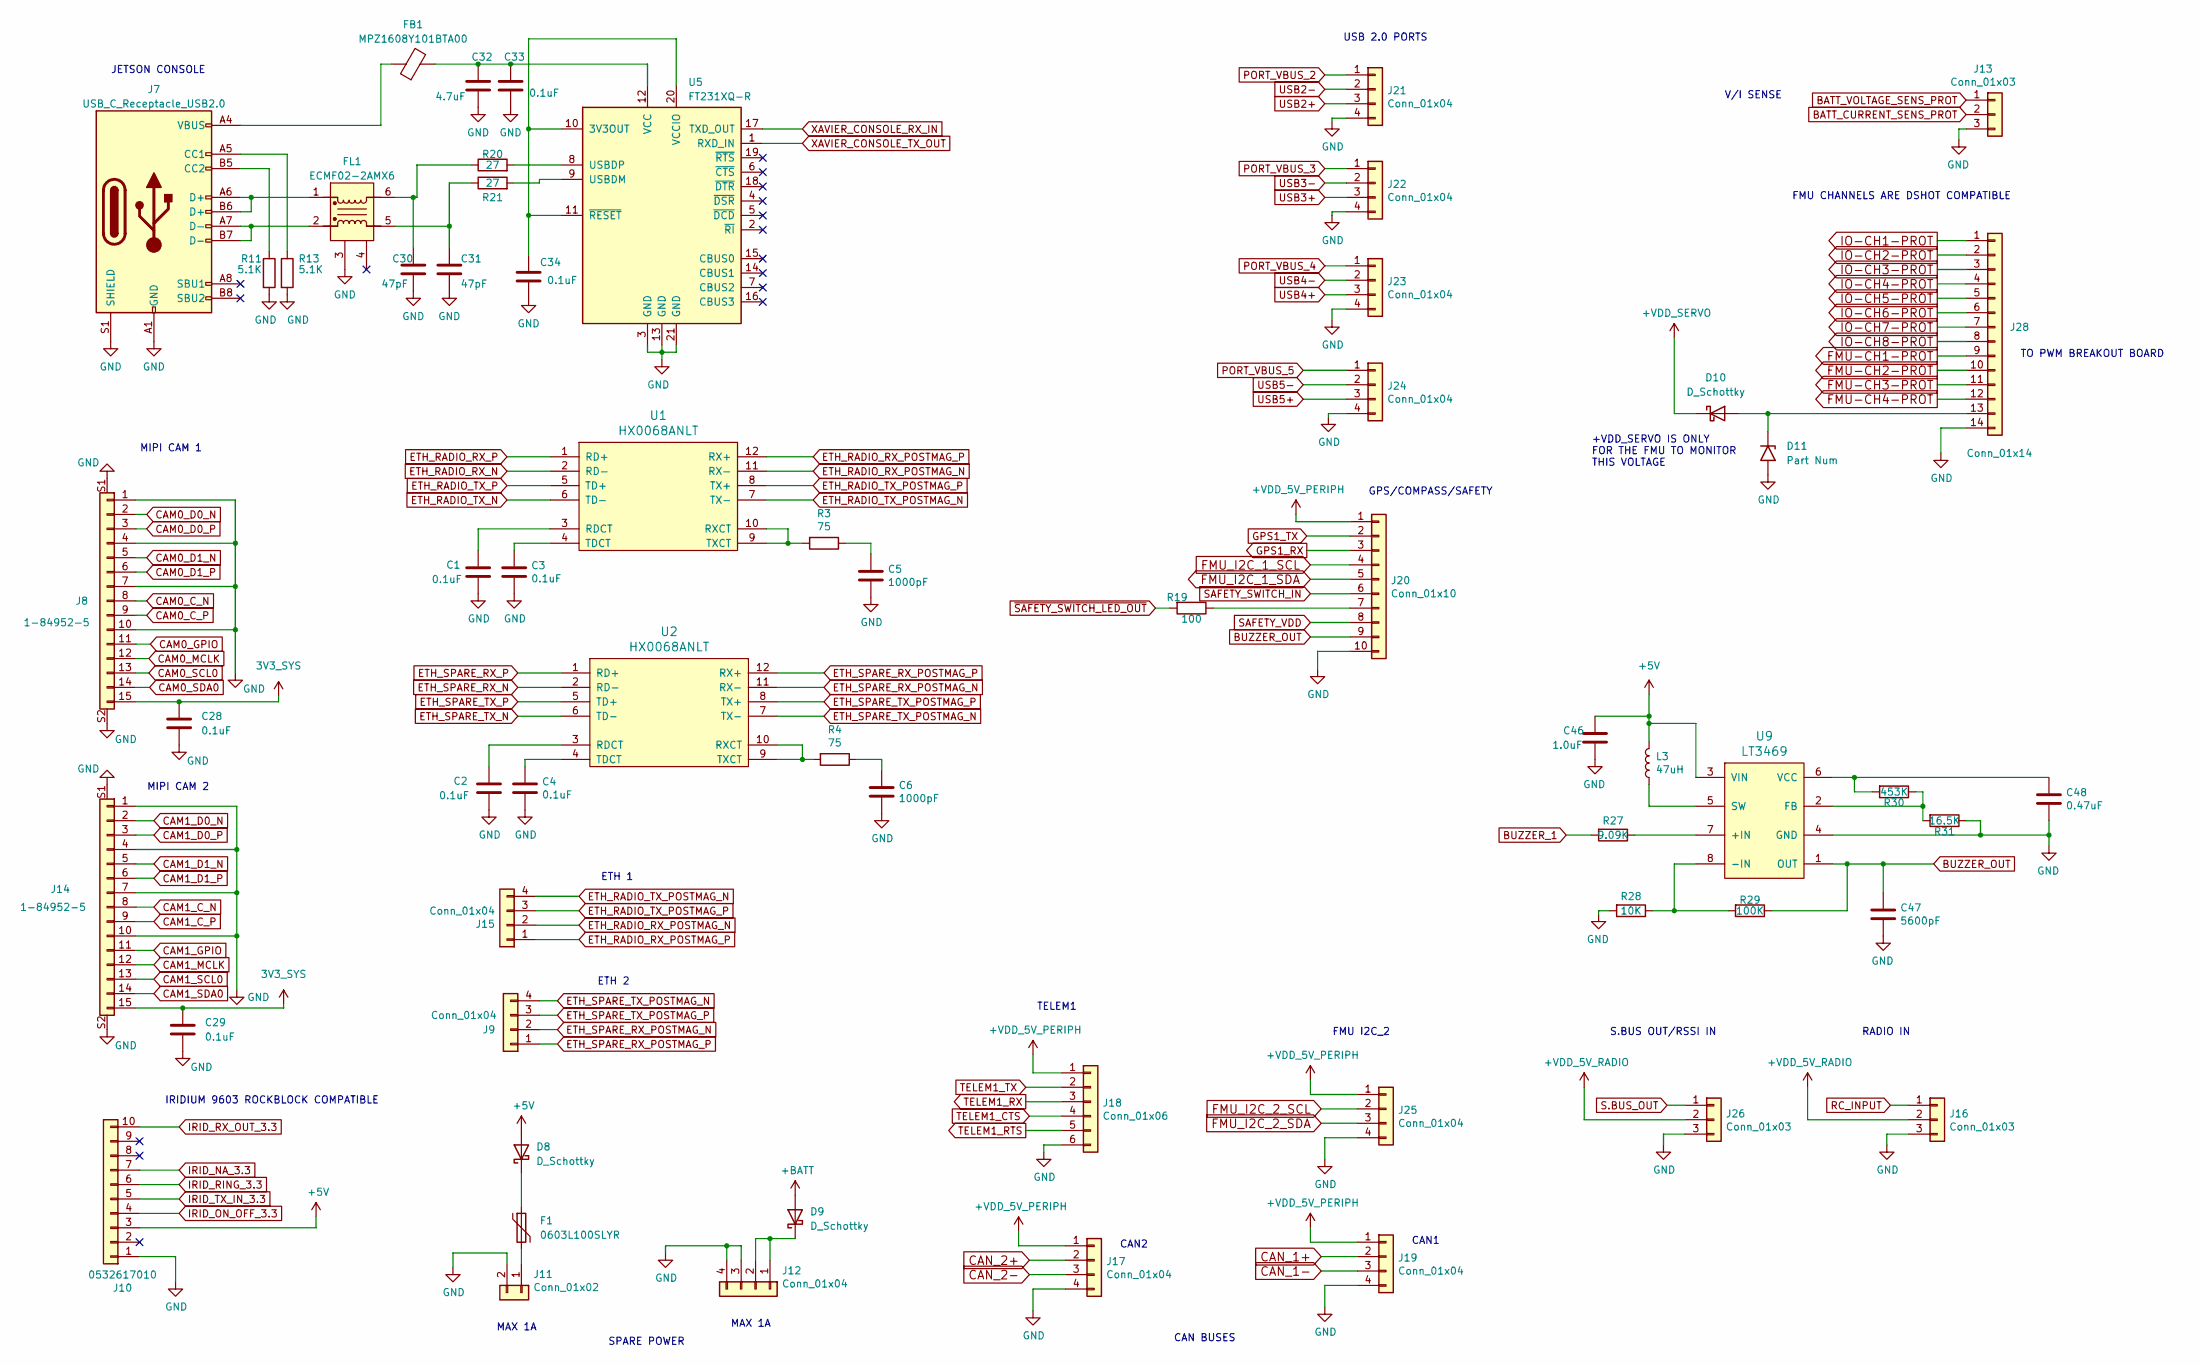
[picture p9: schematic Connectors.kicad_sch, EchoPilot Carrier]

Parts:
C1, C2, C3, C4: 0.1uF; C_0201; Part Num GRM033R61E104KE14J
C5, C6: 1000pF; C_0201; Part Num GRM033R71H102KA12D
C28, C29: 0.1uF; C_0201_0603Metric
C30, C31: 47pF; C_0201_0603Metric; Part Num 02013A470JAT2A
C32: 4.7uF; C_0805_2012Metric; Part Num CL21B475KOFNFNE
C33, C34: 0.1uF; C_0201_0603Metric; Part Num GRM033R61E104KE14J
C46: 1.0uF; C_0201_0603Metric; Part Num CL03A105MO3NRNH
C47: 5600pF; C_0201_0603Metric; Part Num GRM033R61E562KA12D
C48: 0.47uF; C_0201_0603Metric; Part Num EMK063BBJ474KPLF
D8, D9: D_Schottky; D_SMA; Part Num B340LA-13-F
D10: D_Schottky; D_0402_1005Metric; Part Num CDBQC0130L-HF
D11: Part Num; D_0402_1005Metric; Part Num PESD0402-140
F1: 0603L100SLYR; Fuse_0603_1608Metric; Part Num 0603L100SLYR
FB1: MPZ1608Y101BTA00; L_0603_1608Metric; Part Num MPZ1608Y101BTA00
FL1: ECMF02-2AMX6; QFN-6L_STM; Part Num ECMF02-2AMX6
J7: USB_C_Receptacle_USB2.0; USB_C_Receptacle_Amphenol_12401610E4-2A; Part Num 12401610E4#2A
J8, J14: 1-84952-5; TE_1-84952-5; Part Num 1-84952-5
J9, J15, J17, J19, J21, J22, J23, J24, J25: Conn_01x04; JST_GH_SM04B-GHS-TB_1x04-1MP_P1.25mm_Horizontal; Part Num SM04B-GHS-TB(LF)(SN)
J10: 0532617010; Molex_PicoBlade_53261-1071_10x1.25mm_Angled; Part Num 0532617010
J11: Conn_01x02; JST_GH_SM02B-GHS-TB_02x1.25mm_Angled; Part Num SM02B-GHS-TB(LF)(SN)
J12: Conn_01x04; JST_GH_SM04B-GHS-TB_04x1.25mm_Angled; Part Num SM04B-GHS-TB(LF)(SN)
J13, J26: Conn_01x03; JST_GH_SM03B-GHS-TB_1x03-1MP_P1.25mm_Horizontal; Part Num SM03B-GHS-TB(LF)(SN)
J16: Conn_01x03; JST_GH_SM03B-GHS-TB_03x1.25mm_Angled; Part Num SM03B-GHS-TB(LF)(SN)
J18: Conn_01x06; JST_GH_SM06B-GHS-TB_1x06-1MP_P1.25mm_Horizontal; Part Num SM06B-GHS-TB(LF)(SN)
J20: Conn_01x10; JST_GH_SM10B-GHS-TB_10x1.25mm_Angled; Part Num SM10B-GHS-TB(LF)(SN)
J28: Conn_01x14; JST_GH_SM14B-GHS-TB_1x14-1MP_P1.25mm_Horizontal; Part Num SM14B-GHS-TB(LF)(SN)-
L3: 47uH; IND_LQH32CN470K23L; Part Num LQH32CN470K23L
R3, R4: 75; R_0201_0603Metric; Part Num ERJ-1GNF75R0C
R11, R13: 5.1K; R_0201_0603Metric; Part Num ERJ-1GNJ512C
R19: 100; R_0201_0603Metric; Part Num ERJ-U01F1000C
R20, R21: 27; R_0201_0603Metric; Part Num ERJ-1GNJ270C
R27: 9.09K; R_0201_0603Metric; Part Num ERJ-1GNF9091C
R28: 10K; R_0201_0603Metric; Part Num ERJ-U01F1002C
R29: 100K; R_0201_0603Metric; Part Num ERJ-1GEF1003C
R30: 453K; R_0201_0603Metric; Part Num ERJ-1GNF4533C
R31: 16.5K; R_0201_0603Metric; Part Num ERJ-1GNF1652C
U1, U2: HX0068ANLT; HX0068ANLT_r2; Part Num HX0068ANLT
U5: FT231XQ-R; QFN20_FT231XQ_FTD; Part Num FT231XQ-R
U9: LT3469; SOT-23-8; Part Num LT3469ETS8#TRMPBF

Connections:
3V3_SYS: C28.1, C29.1, J8.15, J14.15; also elsewhere on the board
+BATT: D9.2 (A); also elsewhere on the board
+VDD_5V_PERIPH: J17.1, J18.1, J19.1, J20.1, J25.1; also elsewhere on the board
+VDD_5V_RADIO: J16.2, J26.2; also elsewhere on the board
+VDD_SERVO: D10.1 (K); also elsewhere on the board
BATT_CURRENT_SENS_PROT: J13.2; also elsewhere on the board
BATT_VOLTAGE_SENS_PROT: J13.1; also elsewhere on the board
BUZZER_1: R27.2; also elsewhere on the board
BUZZER_OUT: C47.1, J20.9, R29.1, U9.1 (OUT)
CAM0_C_N: J8.8; also elsewhere on the board
CAM0_C_P: J8.9; also elsewhere on the board
CAM0_D0_N: J8.2; also elsewhere on the board
CAM0_D0_P: J8.3; also elsewhere on the board
CAM0_D1_N: J8.5; also elsewhere on the board
CAM0_D1_P: J8.6; also elsewhere on the board
CAM0_GPIO: J8.11; also elsewhere on the board
CAM0_MCLK: J8.12; also elsewhere on the board
CAM0_SCL0: J8.13; also elsewhere on the board
CAM0_SDA0: J8.14; also elsewhere on the board
CAM1_C_N: J14.8; also elsewhere on the board
CAM1_C_P: J14.9; also elsewhere on the board
CAM1_D0_N: J14.2; also elsewhere on the board
CAM1_D0_P: J14.3; also elsewhere on the board
CAM1_D1_N: J14.5; also elsewhere on the board
CAM1_D1_P: J14.6; also elsewhere on the board
CAM1_GPIO: J14.11; also elsewhere on the board
CAM1_MCLK: J14.12; also elsewhere on the board
CAM1_SCL0: J14.13; also elsewhere on the board
CAM1_SDA0: J14.14; also elsewhere on the board
CAN_1+: J19.2; also elsewhere on the board
CAN_1-: J19.3; also elsewhere on the board
CAN_2+: J17.2; also elsewhere on the board
CAN_2-: J17.3; also elsewhere on the board
ETH_RADIO_RX_N: U1.2 (RD-); also elsewhere on the board
ETH_RADIO_RX_P: U1.1 (RD+); also elsewhere on the board
ETH_RADIO_RX_POSTMAG_N: J15.2, U1.11 (RX-)
ETH_RADIO_RX_POSTMAG_P: J15.1, U1.12 (RX+)
ETH_RADIO_TX_N: U1.6 (TD-); also elsewhere on the board
ETH_RADIO_TX_P: U1.5 (TD+); also elsewhere on the board
ETH_RADIO_TX_POSTMAG_N: J15.4, U1.7 (TX-)
ETH_RADIO_TX_POSTMAG_P: J15.3, U1.8 (TX+)
ETH_SPARE_RX_N: U2.2 (RD-); also elsewhere on the board
ETH_SPARE_RX_P: U2.1 (RD+); also elsewhere on the board
ETH_SPARE_RX_POSTMAG_N: J9.2, U2.11 (RX-)
ETH_SPARE_RX_POSTMAG_P: J9.1, U2.12 (RX+)
ETH_SPARE_TX_N: U2.6 (TD-); also elsewhere on the board
ETH_SPARE_TX_P: U2.5 (TD+); also elsewhere on the board
ETH_SPARE_TX_POSTMAG_N: J9.4, U2.7 (TX-)
ETH_SPARE_TX_POSTMAG_P: J9.3, U2.8 (TX+)
FMU-CH1-PROT: J28.9; also elsewhere on the board
FMU-CH2-PROT: J28.10; also elsewhere on the board
FMU-CH3-PROT: J28.11; also elsewhere on the board
FMU-CH4-PROT: J28.12; also elsewhere on the board
FMU_I2C_1_SCL: J20.4; also elsewhere on the board
FMU_I2C_1_SDA: J20.5; also elsewhere on the board
FMU_I2C_2_SCL: J25.2; also elsewhere on the board
FMU_I2C_2_SDA: J25.3; also elsewhere on the board
GND: C1.2, C2.2, C3.2, C4.2, C5.2, C6.2, C28.2, C29.2, C30.2, C31.2, C32.2, C33.2, C34.2, C46.2, C47.2, C48.2, D11.2 (A2), FL1.3 (GND), J7.A1 (GND), J7.A12 (GND), J7.B1 (GND), J7.B12 (GND), J7.S1 (SHIELD), J8.1, J8.4, J8.7, J8.10, J8.S1, J8.S2, J10.1, J11.2, J12.3, J12.4, J13.3, J14.1, J14.4, J14.7, J14.10, J14.S1, J14.S2, J16.3, J17.4, J18.6, J19.4, J20.10, J21.4, J22.4, J23.4, J24.4, J25.4, J26.3, J28.14, R11.2, R13.2, R28.2, R31.1, U5.3 (GND), U5.13 (GND), U5.21 (GND), U9.4 (GND); also elsewhere on the board
GPS1_RX: J20.3; also elsewhere on the board
GPS1_TX: J20.2; also elsewhere on the board
IO-CH1-PROT: J28.1; also elsewhere on the board
IO-CH2-PROT: J28.2; also elsewhere on the board
IO-CH3-PROT: J28.3; also elsewhere on the board
IO-CH4-PROT: J28.4; also elsewhere on the board
IO-CH5-PROT: J28.5; also elsewhere on the board
IO-CH6-PROT: J28.6; also elsewhere on the board
IO-CH7-PROT: J28.7; also elsewhere on the board
IO-CH8-PROT: J28.8; also elsewhere on the board
IRID_NA_3.3: J10.7; also elsewhere on the board
IRID_ON_OFF_3.3: J10.4; also elsewhere on the board
IRID_RING_3.3: J10.6; also elsewhere on the board
IRID_RX_OUT_3.3: J10.10; also elsewhere on the board
IRID_TX_IN_3.3: J10.5; also elsewhere on the board
unnamed: C1.1, U1.3 (RDCT)
unnamed: C2.1, U2.3 (RDCT)
unnamed: C3.1, U1.4 (TDCT)
unnamed: C4.1, U2.4 (TDCT)
unnamed: C5.1, R3.1
unnamed: C6.1, R4.1
unnamed: C30.1, FL1.6 (D+_OUT), R20.1
unnamed: C31.1, FL1.5 (D-_OUT), R21.1
unnamed: C32.1, C33.1, FB1.2, U5.12 (VCC)
unnamed: C34.1, U5.10 (3V3OUT), U5.11 (~RESET), U5.20 (VCCIO)
unnamed: C48.1, R30.2, U9.6 (VCC)
unnamed: D8.1 (K), F1.1
unnamed: D9.1 (K), J12.1, J12.2
unnamed: D10.2 (A), D11.1 (A1), J28.13
unnamed: F1.2, J11.1
unnamed: FB1.1, J7.A4 (VBUS), J7.A9 (VBUS), J7.B4 (VBUS), J7.B9 (VBUS)
unnamed: FL1.1 (D+_IN), J7.A6 (D+), J7.B6 (D+)
unnamed: FL1.2 (D-_IN), J7.A7 (D-), J7.B7 (D-)
unnamed: J7.A5 (CC1), R13.1
unnamed: J7.B5 (CC2), R11.1
unnamed: J20.7, R19.1
unnamed: L3.1, U9.5 (SW)
unnamed: R3.2, U1.9 (TXCT), U1.10 (RXCT)
unnamed: R4.2, U2.9 (TXCT), U2.10 (RXCT)
unnamed: R20.2, U5.8 (USBDP)
unnamed: R21.2, U5.9 (USBDM)
unnamed: R27.1, U9.7 (+IN)
unnamed: R28.1, R29.2, U9.8 (-IN)
unnamed: R30.1, R31.2, U9.2 (FB)
PORT_VBUS_2: J21.1; also elsewhere on the board
PORT_VBUS_3: J22.1; also elsewhere on the board
PORT_VBUS_4: J23.1; also elsewhere on the board
PORT_VBUS_5: J24.1; also elsewhere on the board
RC_INPUT: J16.1; also elsewhere on the board
S.BUS_OUT: J26.1; also elsewhere on the board
SAFETY_SWITCH_IN: J20.6; also elsewhere on the board
SAFETY_VDD: J20.8; also elsewhere on the board
TELEM1_CTS: J18.4; also elsewhere on the board
TELEM1_RTS: J18.5; also elsewhere on the board
TELEM1_RX: J18.3; also elsewhere on the board
TELEM1_TX: J18.2; also elsewhere on the board
USB2+: J21.3; also elsewhere on the board
USB2-: J21.2; also elsewhere on the board
USB3+: J22.3; also elsewhere on the board
USB3-: J22.2; also elsewhere on the board
USB4+: J23.3; also elsewhere on the board
USB4-: J23.2; also elsewhere on the board
USB5+: J24.3; also elsewhere on the board
USB5-: J24.2; also elsewhere on the board
XAVIER_CONSOLE_RX_IN: U5.17 (TXD_OUT); also elsewhere on the board
XAVIER_CONSOLE_TX_OUT: U5.1 (RXD_IN); also elsewhere on the board
~SAFETY_SWITCH_LED_OUT: R19.2; also elsewhere on the board

Notes on the sheet:
MIPI CAM 1
IRIDIUM 9603 ROCKBLOCK COMPATIBLE
V/I SENSE
JETSON CONSOLE
+VDD_SERVO IS ONLY FOR THE FMU TO MONITOR THIS VOLTAGE
ETH 1
GPS/COMPASS/SAFETY
TELEM1
CAN1
SPARE POWER
MAX 1A
S.BUS OUT/RSSI IN
CAN BUSES
USB 2.0 PORTS
MIPI CAM 2
FMU I2C_2
ETH 2
RADIO IN
FMU CHANNELS ARE DSHOT COMPATIBLE
CAN2
TO PWM BREAKOUT BOARD
