EchoMAV/echopilot_ai_carrier/echopilot_ai_carrier.kicad_pcb

## KiCad design echopilot_ai_carrier.kicad_pcb (continued)

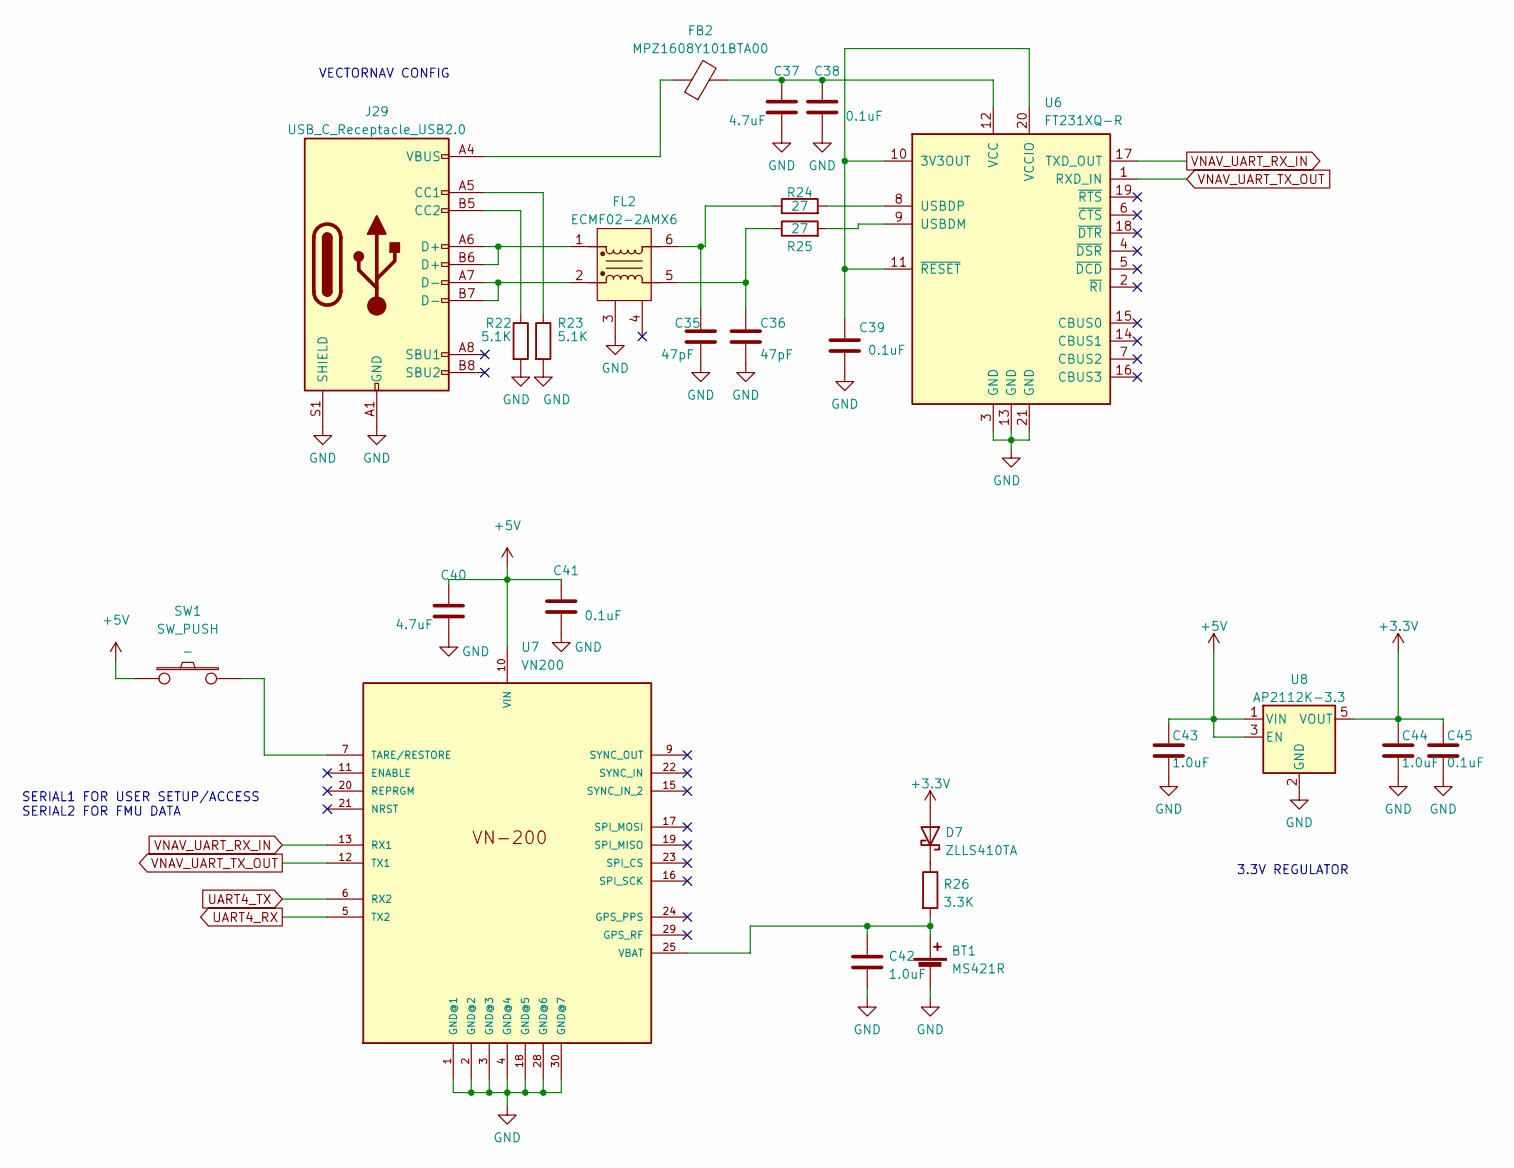
[picture p10: schematic vectornav.kicad_sch]

Parts:
BT1: MS421R; SEIKO_ML414H_IV01E; Part Num MS421R IV03E
C35, C36: 47pF; C_0201_0603Metric; Part Num 02013A470JAT2A
C37, C40: 4.7uF; C_0805_2012Metric; Part Num CL21B475KOFNFNE
C38, C39, C41: 0.1uF; C_0201_0603Metric; Part Num GRM033R61E104KE14J
C42, C43, C44: 1.0uF; C_0805_2012Metric; Part Num C2012X7R1E105K125AB
C45: 0.1uF; C_0402_1005Metric; Part Num CL05B104KB5NNNC
D7: ZLLS410TA; D_SOD-323; Part Num ZLLS410TA
FB2: MPZ1608Y101BTA00; L_0603_1608Metric; Part Num MPZ1608Y101BTA00
FL2: ECMF02-2AMX6; QFN-6L_STM; Part Num ECMF02-2AMX6
J29: USB_C_Receptacle_USB2.0; USB_C_Receptacle_Amphenol_12401610E4-2A; Part Num 12401610E4#2A
R22, R23: 5.1K; R_0201_0603Metric; Part Num ERJ-1GNJ512C
R24, R25: 27; R_0201_0603Metric; Part Num ERJ-1GNJ270C
R26: 3.3K; R_0402_1005Metric; Part Num ERJ-PA2F3301X
SW1: SW_PUSH; SW_B3U-1000P; Voltage _; Tolerance _; Part Num B3U-1000P
U6: FT231XQ-R; QFN20_FT231XQ_FTD; Part Num FT231XQ-R
U7: VN200; 7X8CASTLE
U8: AP2112K-3.3; SOT-23-5; Part Num AP2112K-3.3TRG1

Connections:
+3V3: C44.1, C45.1, D7.2 (A), U8.5 (VOUT)
GND: BT1.2 (-), C35.2, C36.2, C37.2, C38.2, C39.2, C40.2, C41.2, C42.2, C43.2, C44.2, C45.2, FL2.3 (GND), J29.A1 (GND), J29.A12 (GND), J29.B1 (GND), J29.B12 (GND), J29.S1 (SHIELD), R22.2, R23.2, U6.3 (GND), U6.13 (GND), U6.21 (GND), U7.1 (GND@1), U7.2 (GND@2), U7.3 (GND@3), U7.4 (GND@4), U7.18 (GND@5), U7.28 (GND@6), U7.30 (GND@7), U8.2 (GND); also elsewhere on the board
unnamed: BT1.1 (+), C42.1, R26.2, U7.25 (VBAT)
unnamed: C35.1, FL2.6 (D+_OUT), R24.1
unnamed: C36.1, FL2.5 (D-_OUT), R25.1
unnamed: C37.1, C38.1, FB2.2, U6.12 (VCC)
unnamed: C39.1, U6.10 (3V3OUT), U6.11 (~RESET), U6.20 (VCCIO)
unnamed: D7.1 (K), R26.1
unnamed: FB2.1, J29.A4 (VBUS), J29.A9 (VBUS), J29.B4 (VBUS), J29.B9 (VBUS)
unnamed: FL2.1 (D+_IN), J29.A6 (D+), J29.B6 (D+)
unnamed: FL2.2 (D-_IN), J29.A7 (D-), J29.B7 (D-)
unnamed: J29.A5 (CC1), R23.1
unnamed: J29.B5 (CC2), R22.1
unnamed: R24.2, U6.8 (USBDP)
unnamed: R25.2, U6.9 (USBDM)
unnamed: SW1.2, U7.7 (TARE/RESTORE)
UART4_RX: U7.5 (TX2); also elsewhere on the board
UART4_TX: U7.6 (RX2); also elsewhere on the board
VNAV_UART_RX_IN: U6.17 (TXD_OUT), U7.13 (RX1)
VNAV_UART_TX_OUT: U6.1 (RXD_IN), U7.12 (TX1)

Notes on the sheet:
3.3V REGULATOR
SERIAL1 FOR USER SETUP/ACCESS SERIAL2 FOR FMU DATA
VECTORNAV CONFIG

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
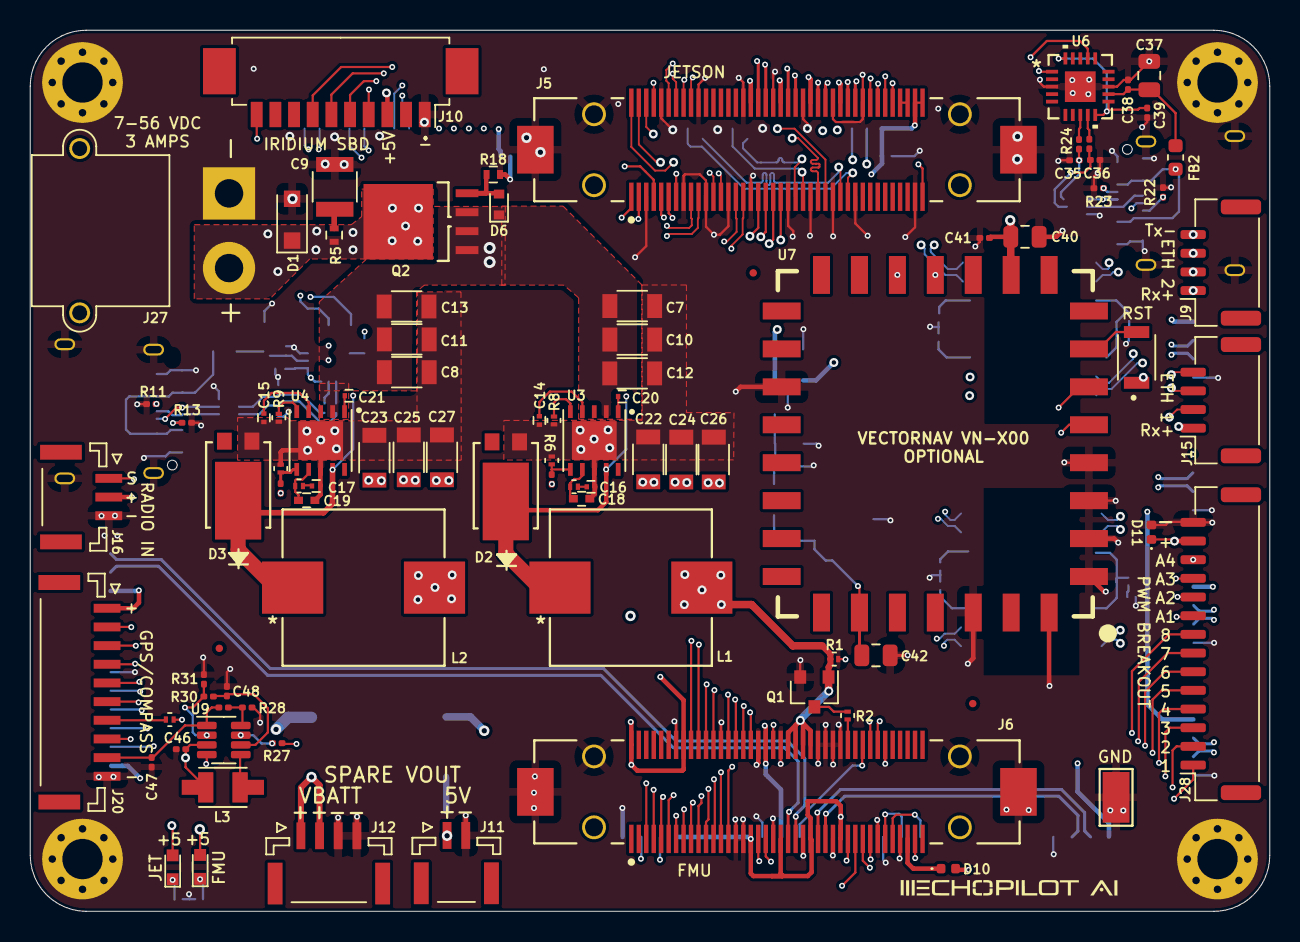
[picture p11: board echopilot_ai_carrier.kicad_pcb from above]

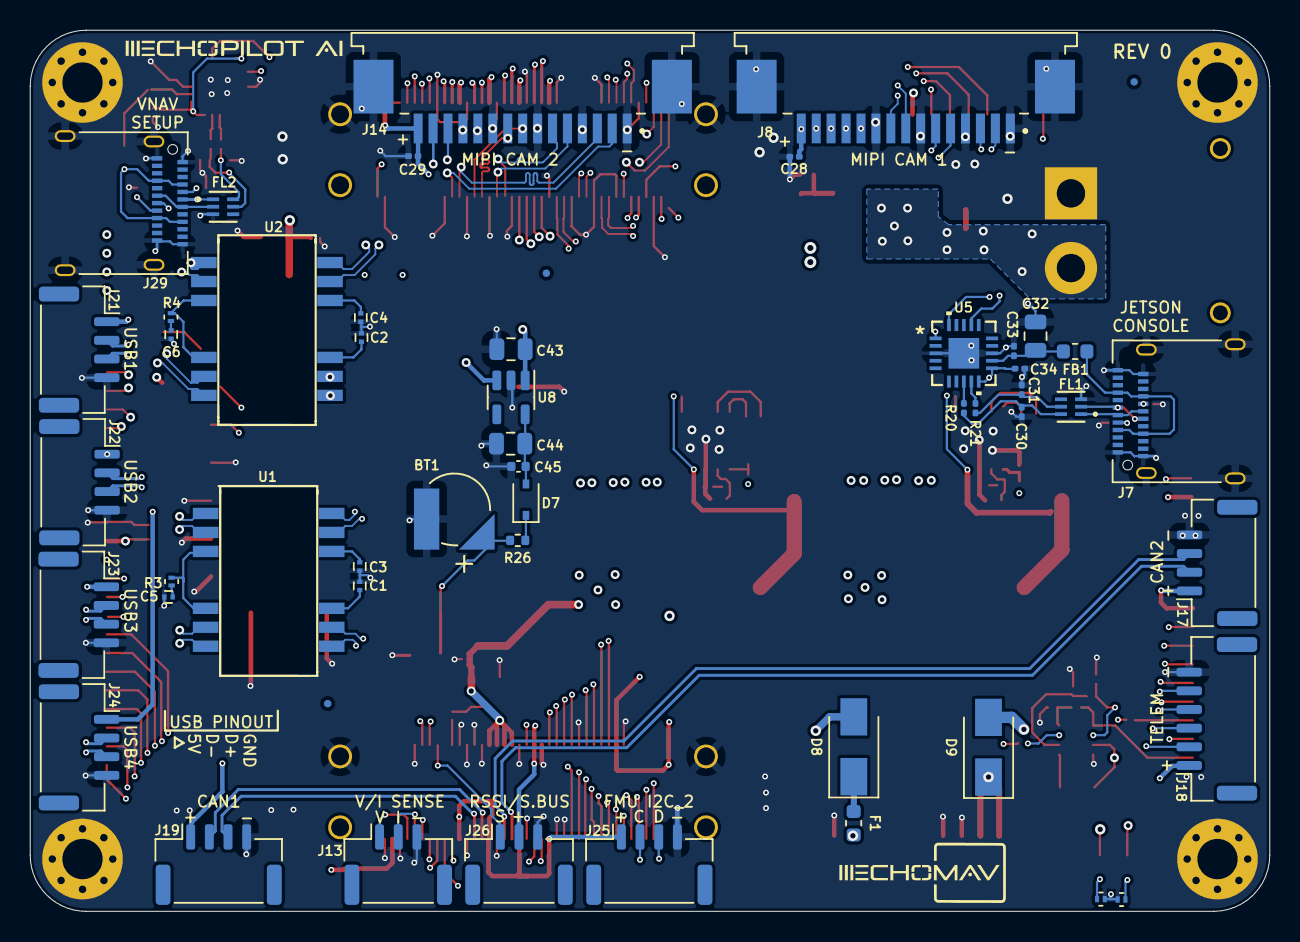
[picture p12: board echopilot_ai_carrier.kicad_pcb from below]

Board: 8 copper layers, 83.0 x 59.0 mm, 147 parts (52 on the bottom side), 168 nets.
